SolderedElectronics/Soldered-Inkplate-6-FLICK-hardware-design/CAD/V1.2.0/Source 3D files/Inkplate 6 FLICK bottom  v1.1.0.step

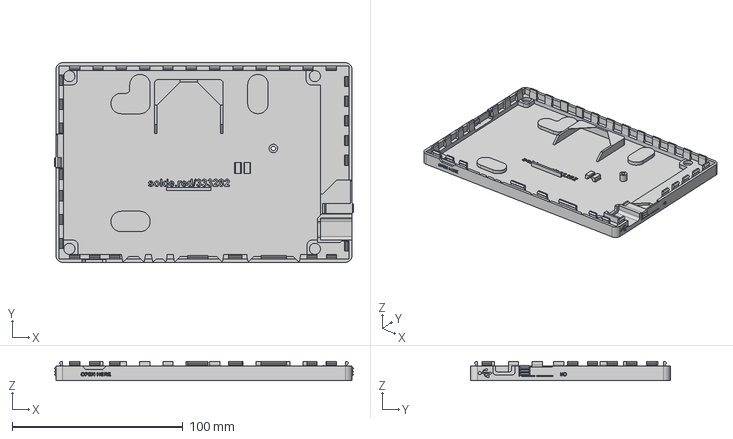
[picture p1: CAD file, 2024-10-20]
CAD/V1.2.0/Source 3D files/Inkplate 6 FLICK bottom v1.1.0.step
174.9 x 116.8 x 11.3 mm
