SolderedElectronics/Soldered-Inkplate-6-FLICK-hardware-design/OUTPUTS/V1.2.0/3D files/Inkplate 6 FLICK Top v1.1.1..stl

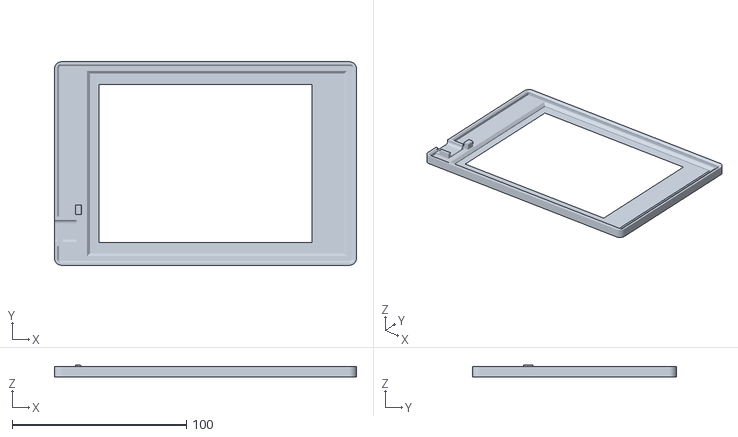
[picture p2: CAD file, 2024-10-20]
OUTPUTS/V1.2.0/3D files/Inkplate 6 FLICK Top v1.1.1..stl
173.3 x 116.8 x 6.60
