SolderedElectronics/Soldered-Inkplate-6-FLICK-hardware-design/CAD/V1.0.0/Source 3D files/Soldered Inkplate 6plus v1.2.0. Bottom v1.2.3..step

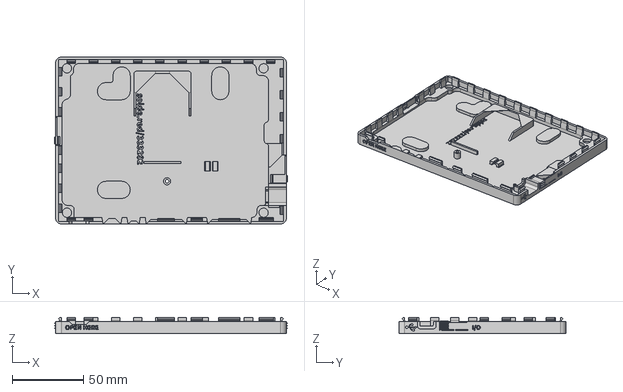
[picture p3: CAD file, 2025-01-28, an earlier design]
CAD/V1.0.0/Source 3D files/Soldered Inkplate 6plus v1.2.0. Bottom v1.2.3..step
163.0 x 116.8 x 11.3 mm
