SolderedElectronics/Soldered-Inkplate-6-FLICK-hardware-design/CAD/V1.0.0/Source 3D files/Soldered Inkplate 6plus v1.2.0. Top v1.2.1..step

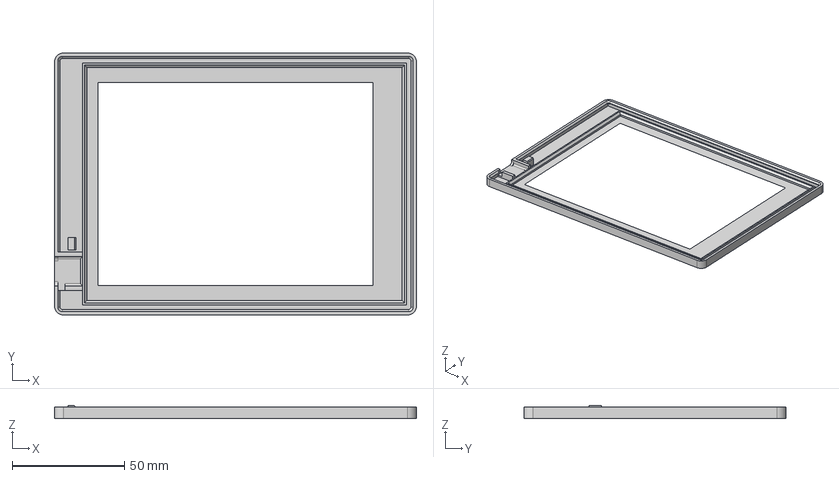
[picture p4: CAD file, 2025-01-28, an earlier design]
CAD/V1.0.0/Source 3D files/Soldered Inkplate 6plus v1.2.0. Top v1.2.1..step
161.4 x 116.8 x 5.60 mm
