SolderedElectronics/Soldered-Inkplate-6-FLICK-hardware-design/(list of files, cad)

Other CAD files:
CAD/V1.2.0/Source 3D files/Inkplate 6 FLICK Top v1.1.1.step
OUTPUTS/V1.2.0/3D files/Inkplate 6 FLICK bottom v1.1.0..stl
CAD/V1.0.0/Source 3D files/Soldered Inkplate 6plus v1.2.0. Bottom v1.2.3..f3d
CAD/V1.0.0/Source 3D files/Soldered Inkplate 6plus v1.2.0. Top v1.2.1..f3d
