SolderedElectronics/Soldered-Inkplate-6-FLICK-hardware-design/OUTPUTS/V1.2.0/Soldered Inkplate 6 FLICK Schematics.pdf

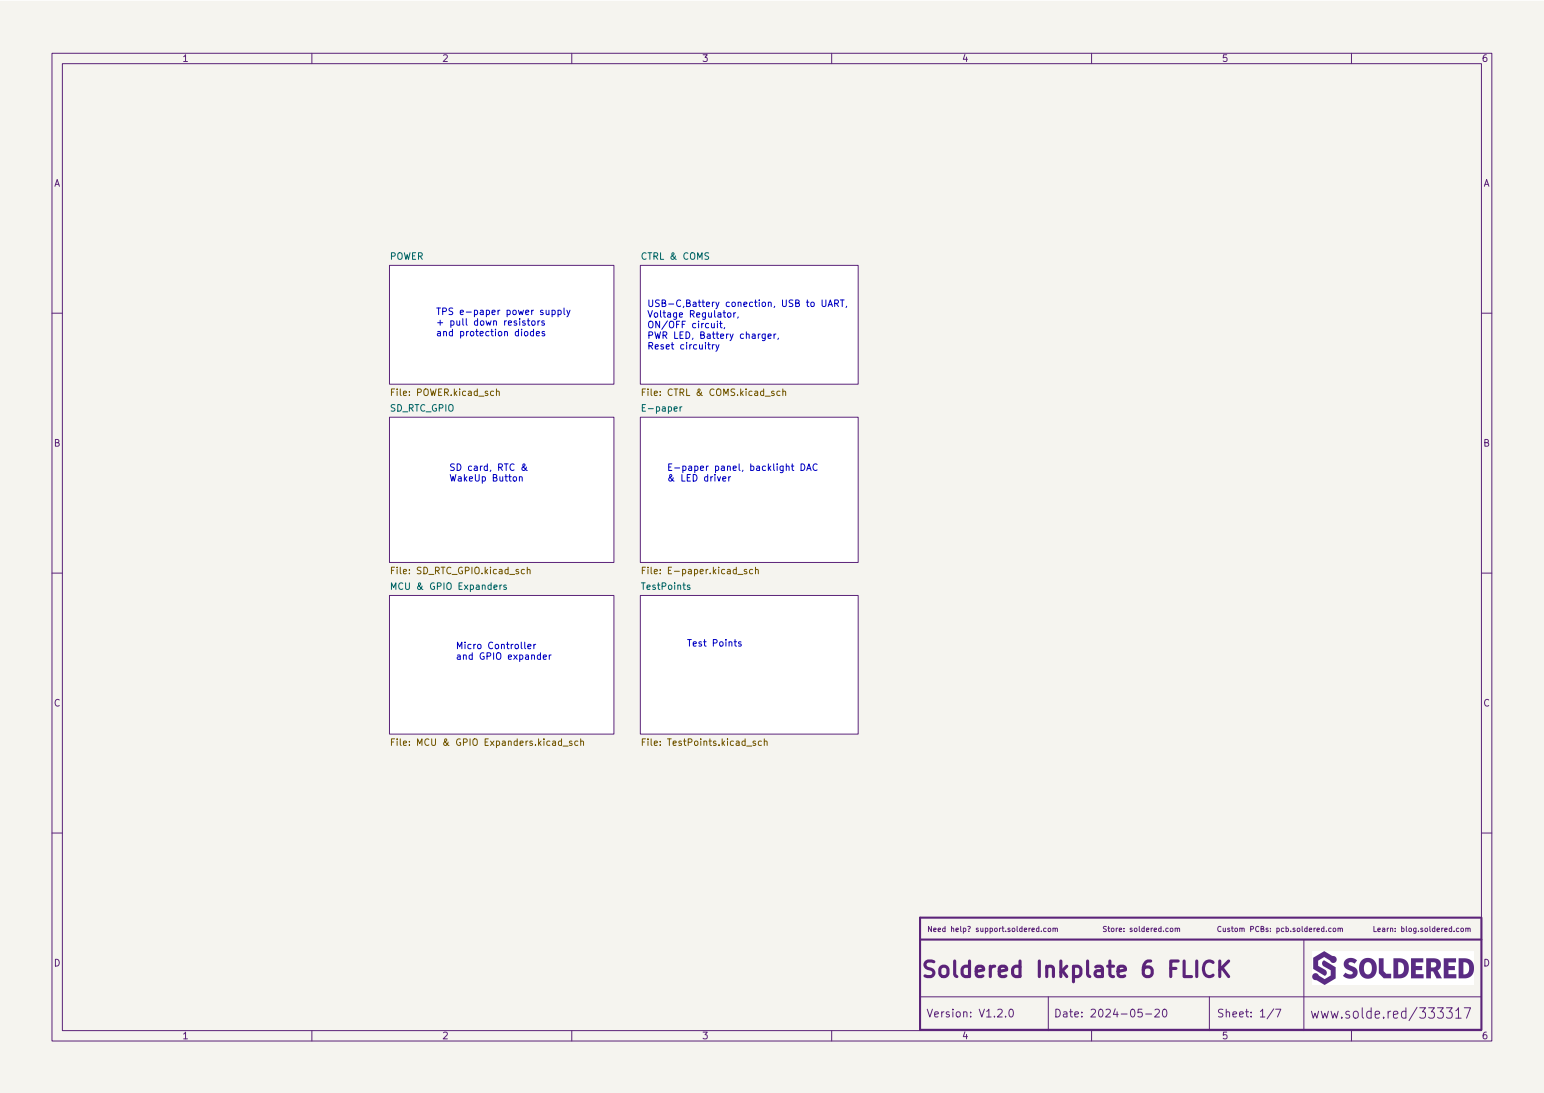
[picture p5: page 1]

POWER
and protection diodes Micro Controller and GPIO expander SD card, RTC & WakeUp Button
Reset circuitry Test Points E-paper panel, backlight DAC

USB-C,Battery conection, USB to UART,
Voltage Regulator, ON/OFF circuit, PWR LED, Battery charger,

TPS e-paper power supply
+ pull down resistors

File: CTRL & COMS.kicad_sch E-paper

File: SD_RTC_GPIO.kicad_sch MCU & GPIO Expanders

File: E-paper.kicad_sch TestPoints File: TestPoints.kicad_sch

File: MCU & GPIO Expanders.kicad_sch

Learn: blog.soldered.com

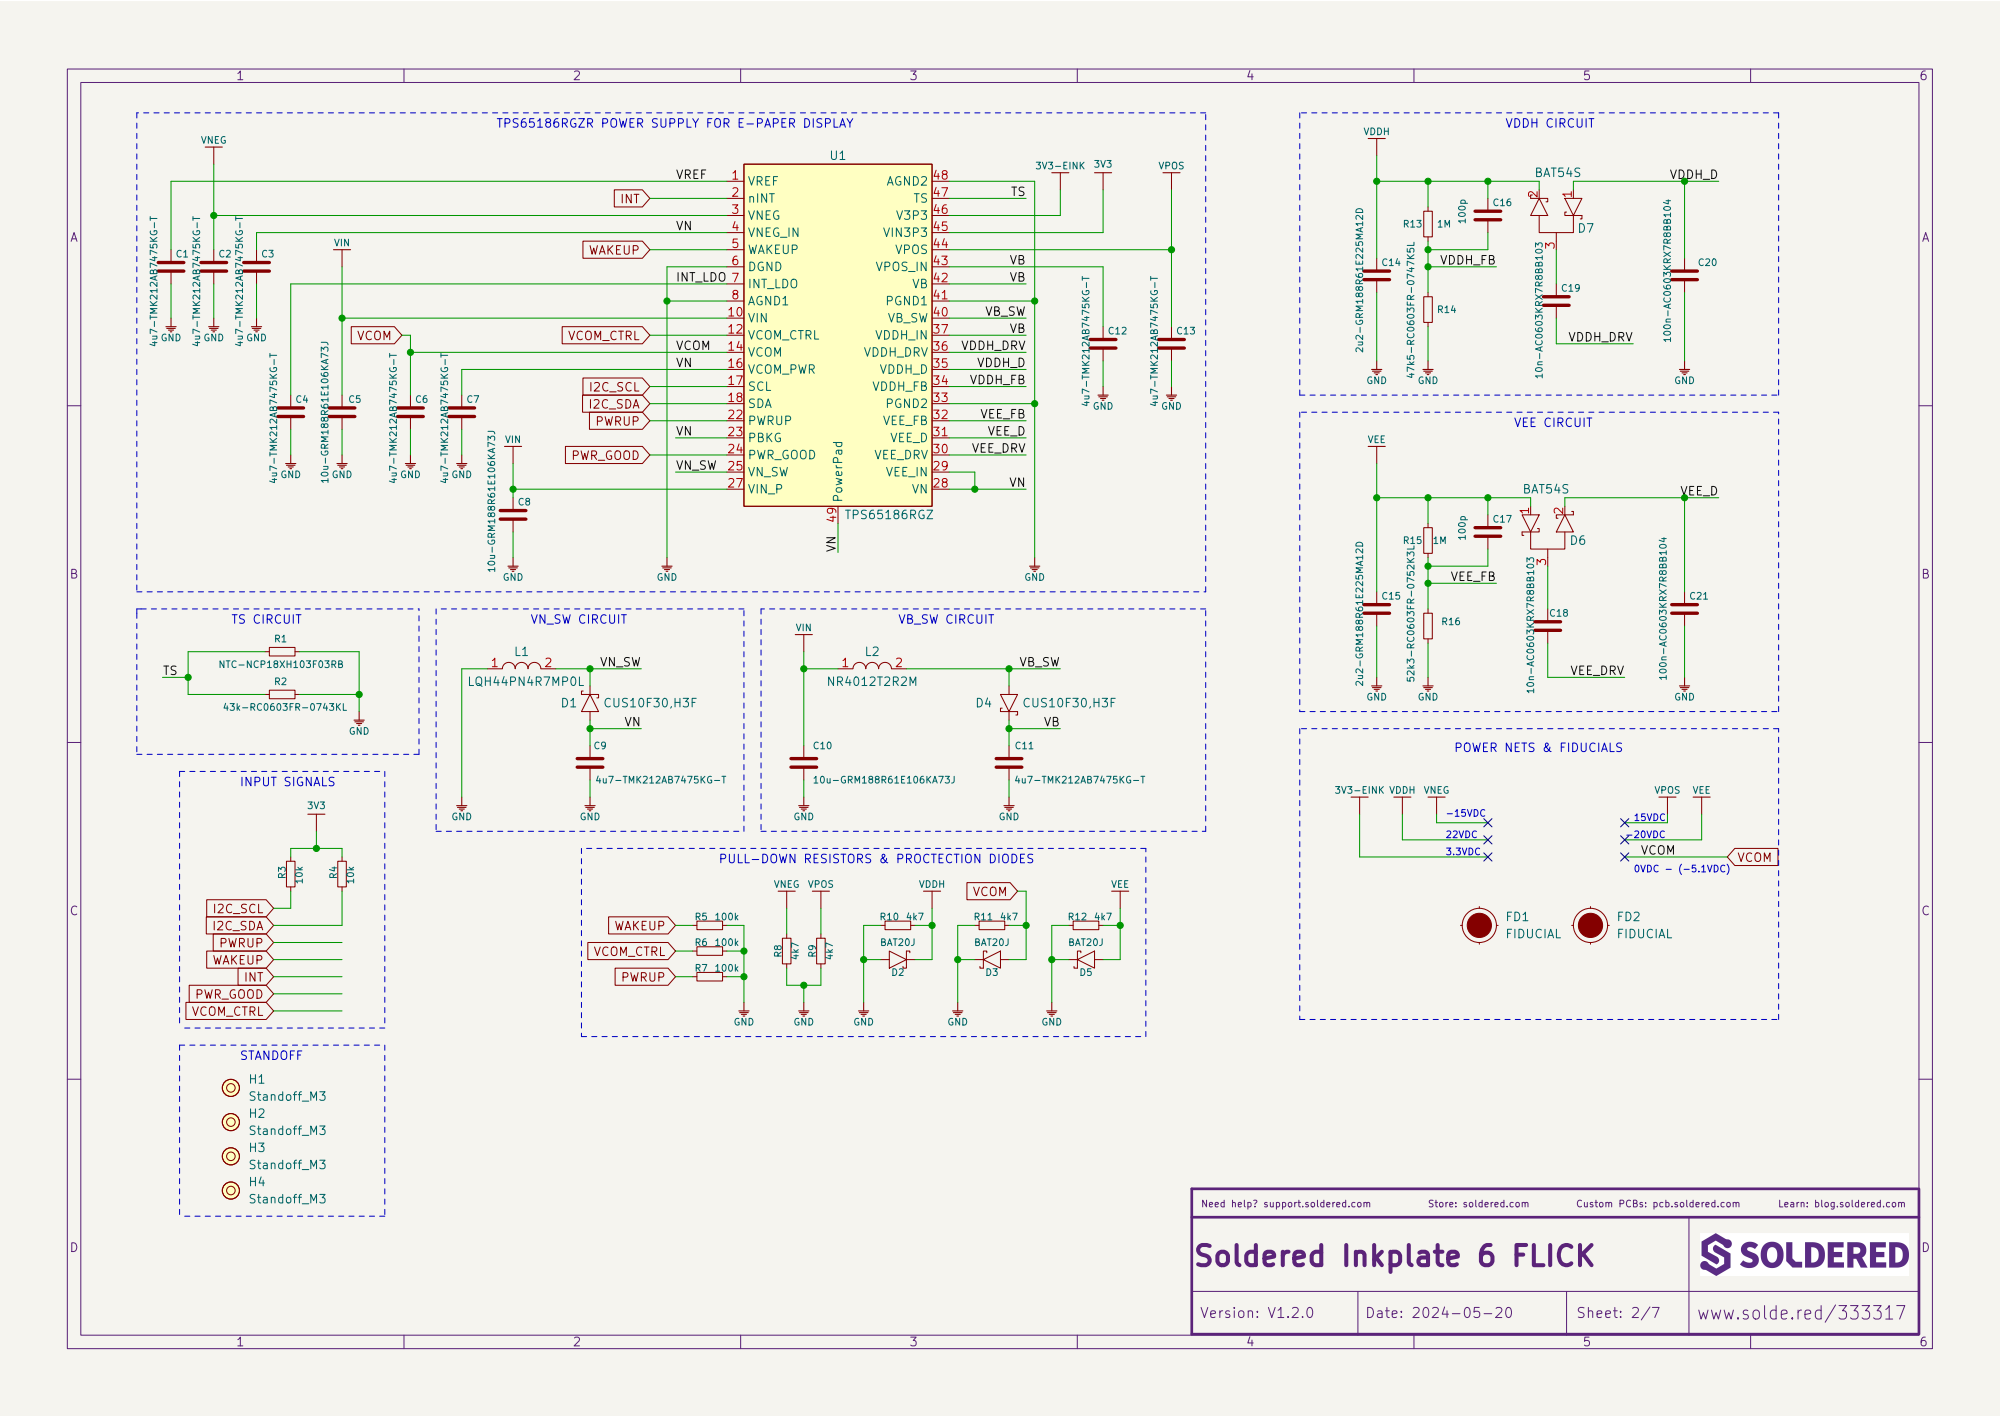
[picture p6: page 2]

INT_LDO | VB

Learn: blog.soldered.com

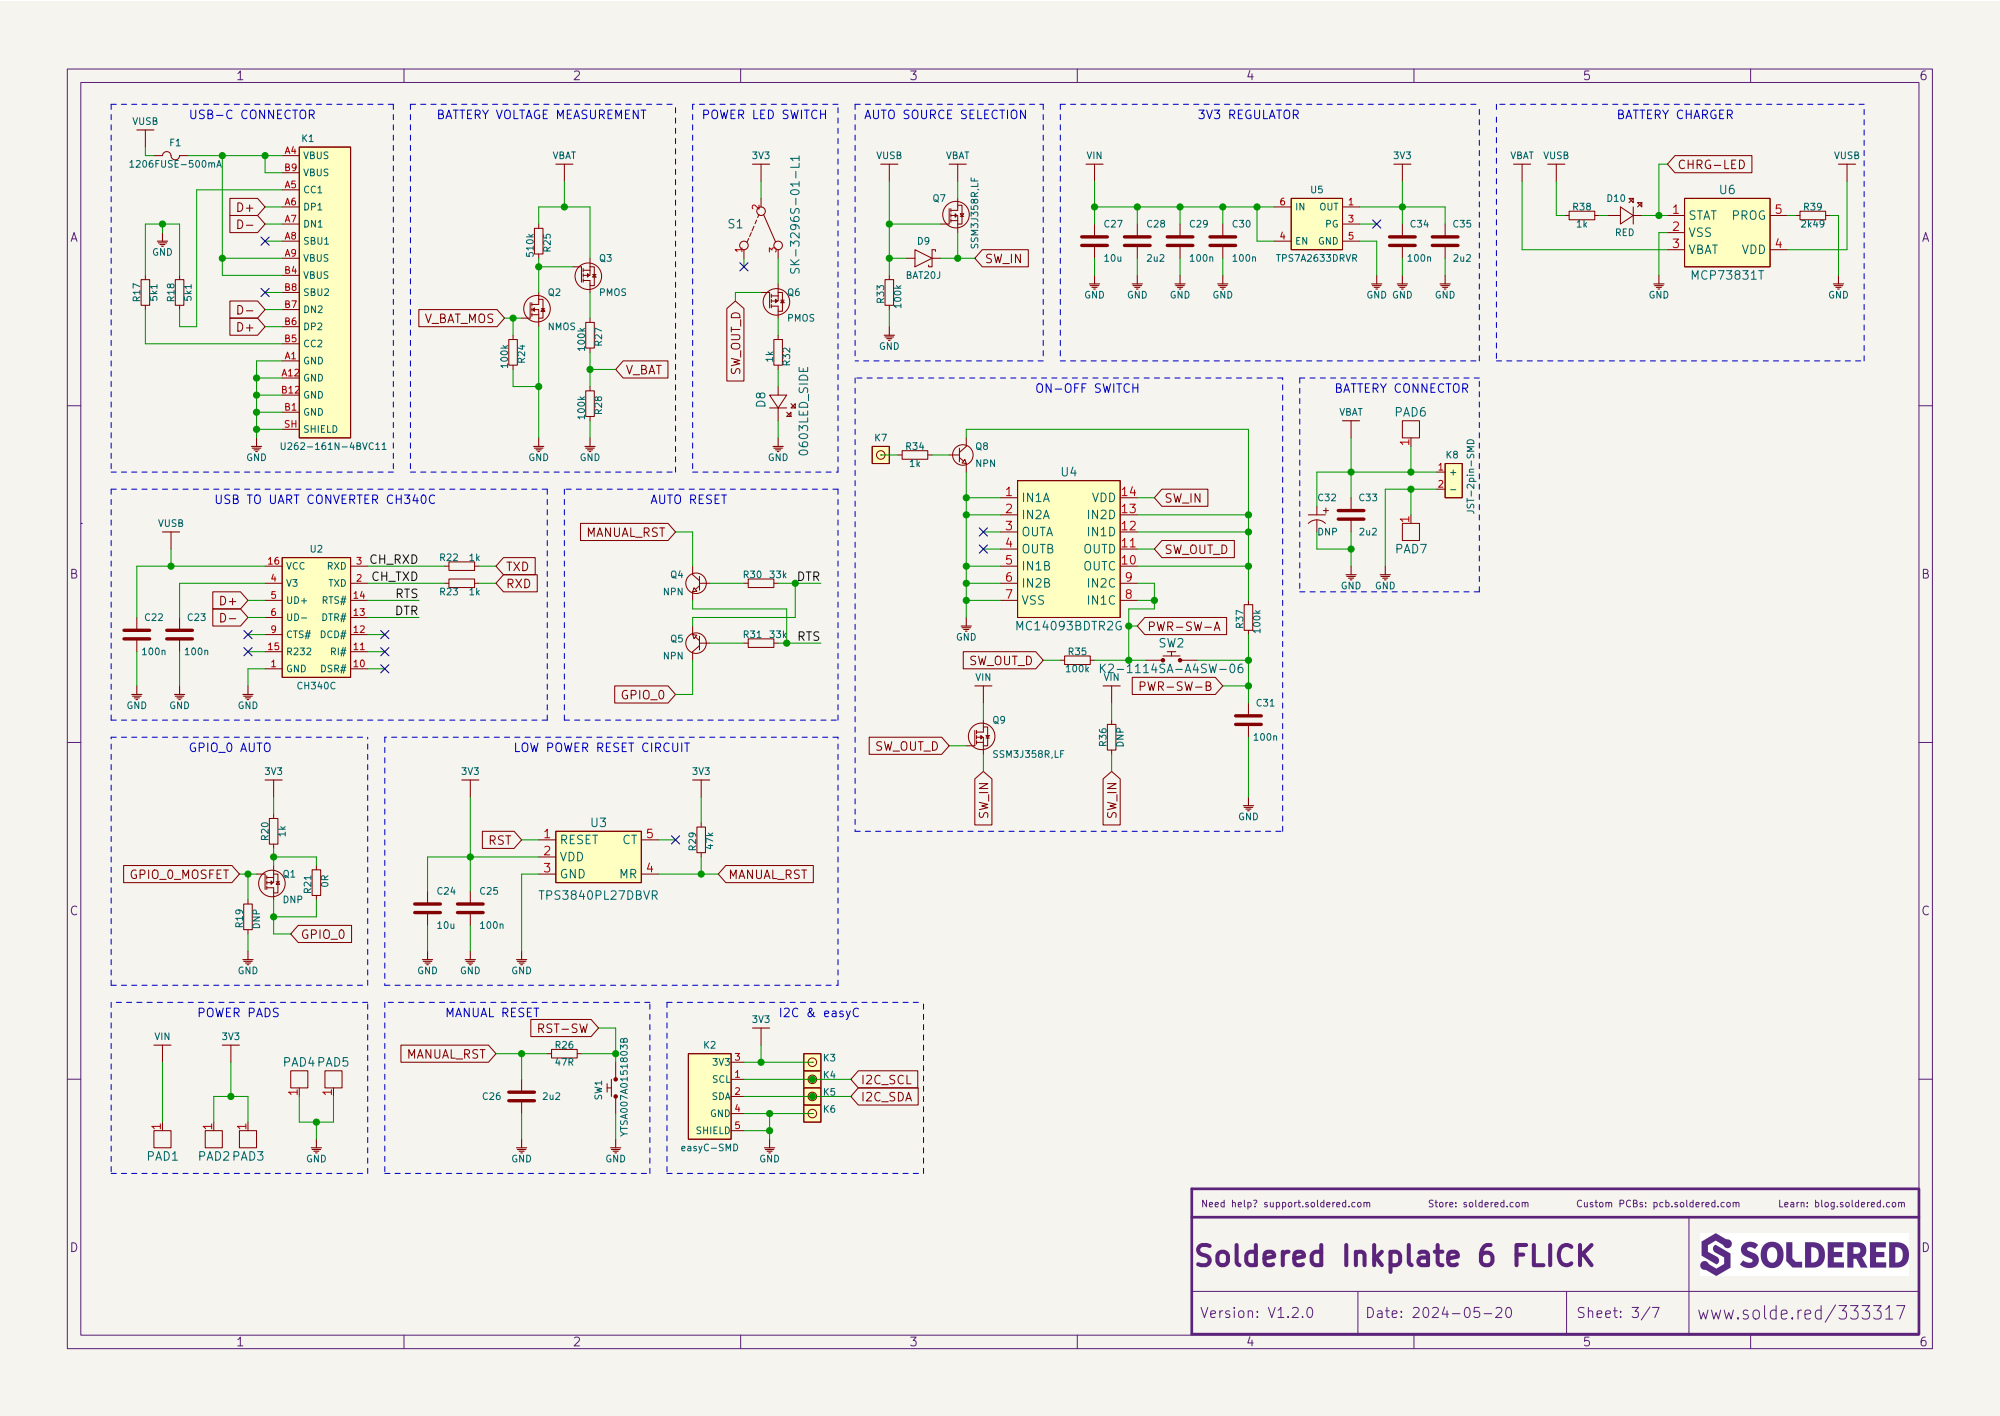
[picture p7: page 3]

USB TO UART CONVERTER CH340C

1 PAD3 R29 47k GND 1 DSR# 10 RI# 11 DCD# 12 DTR# 13 RTS# 14 R232 15 VCC 16 TXD 2 RXD 3 V3 4 UD+ 5 UD- 6 CTS# 9 U2 CH340C

LOW POWER RESET CIRCUIT

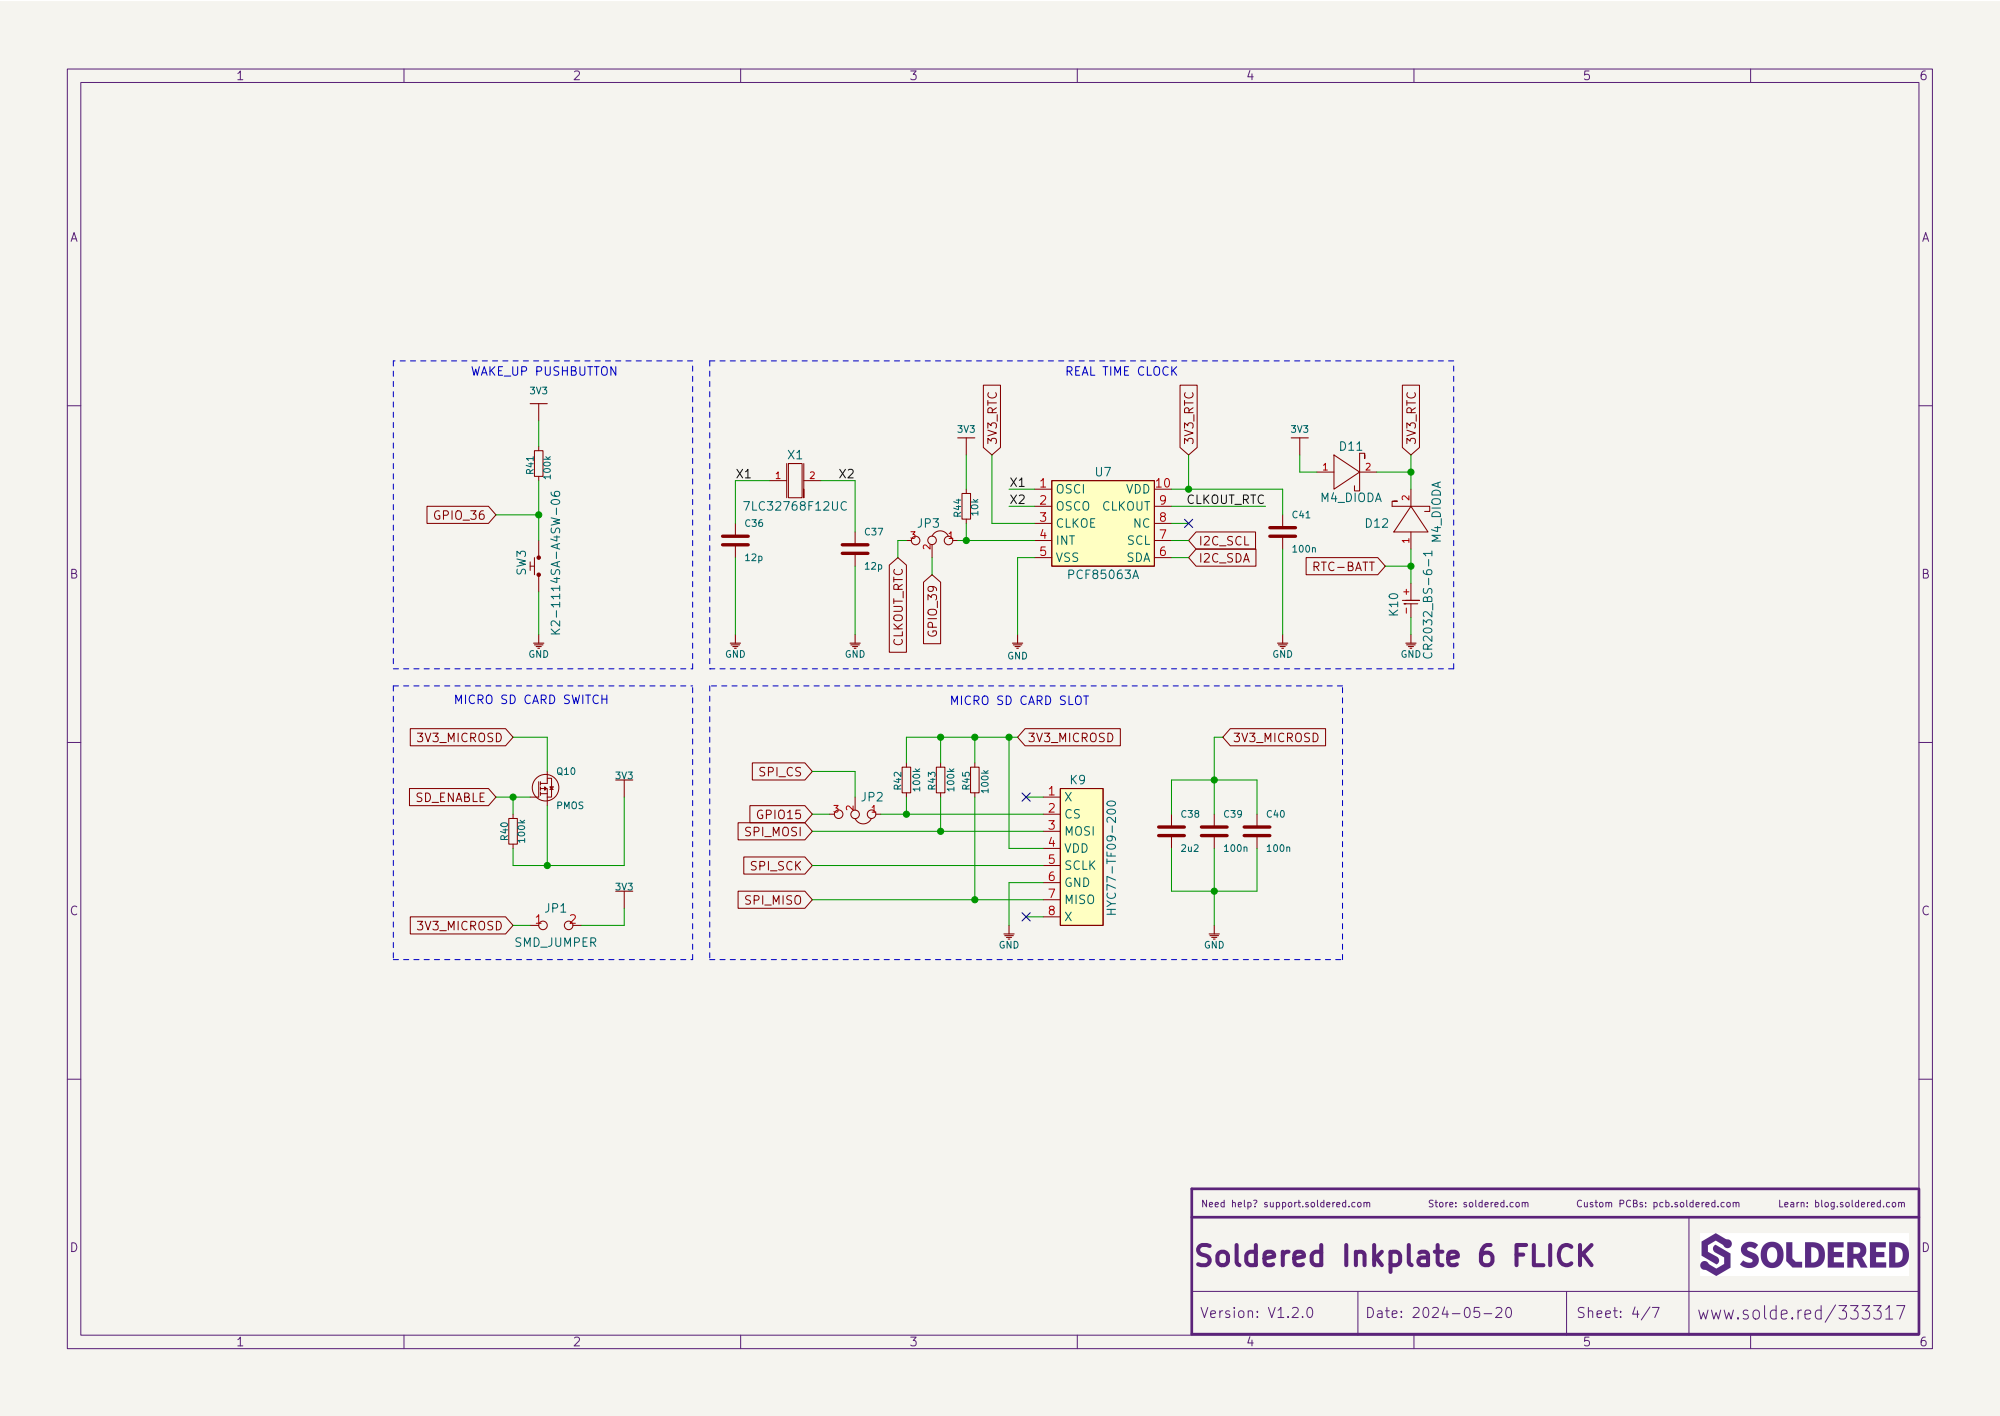
[picture p8: page 4]

REAL TIME CLOCK MICRO SD CARD SLOT WAKE_UP PUSHBUTTON

Learn: blog.soldered.com

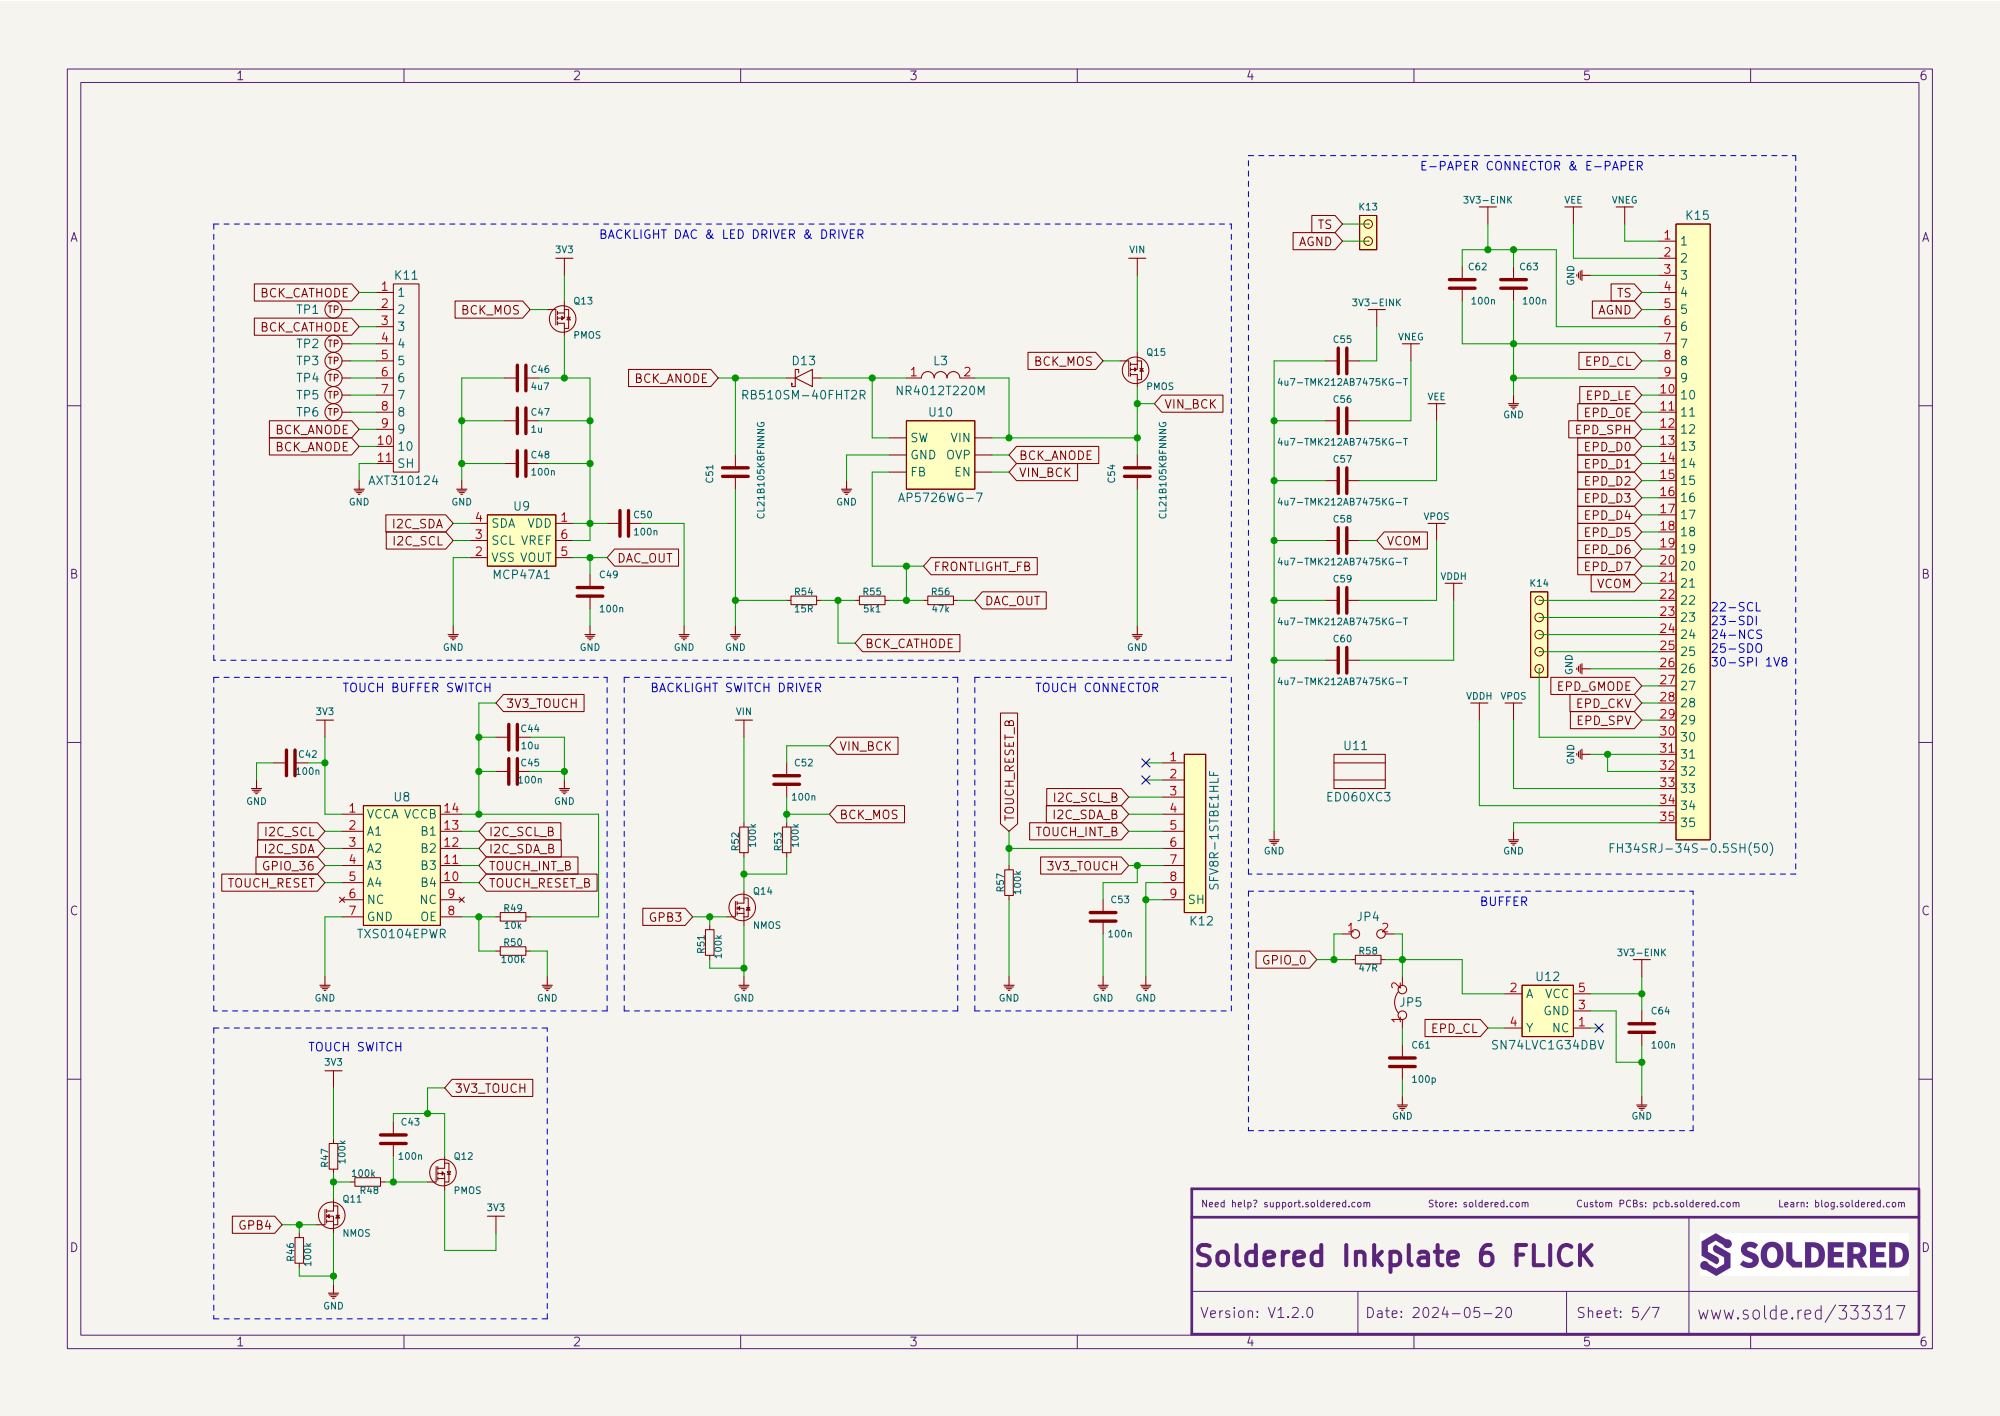
[picture p9: page 5]

BACKLIGHT DAC & LED DRIVER & DRIVER
VIN Q13 PMOS

100n GND TP4 TP TP6 TP TP5 TP

Learn: blog.soldered.com

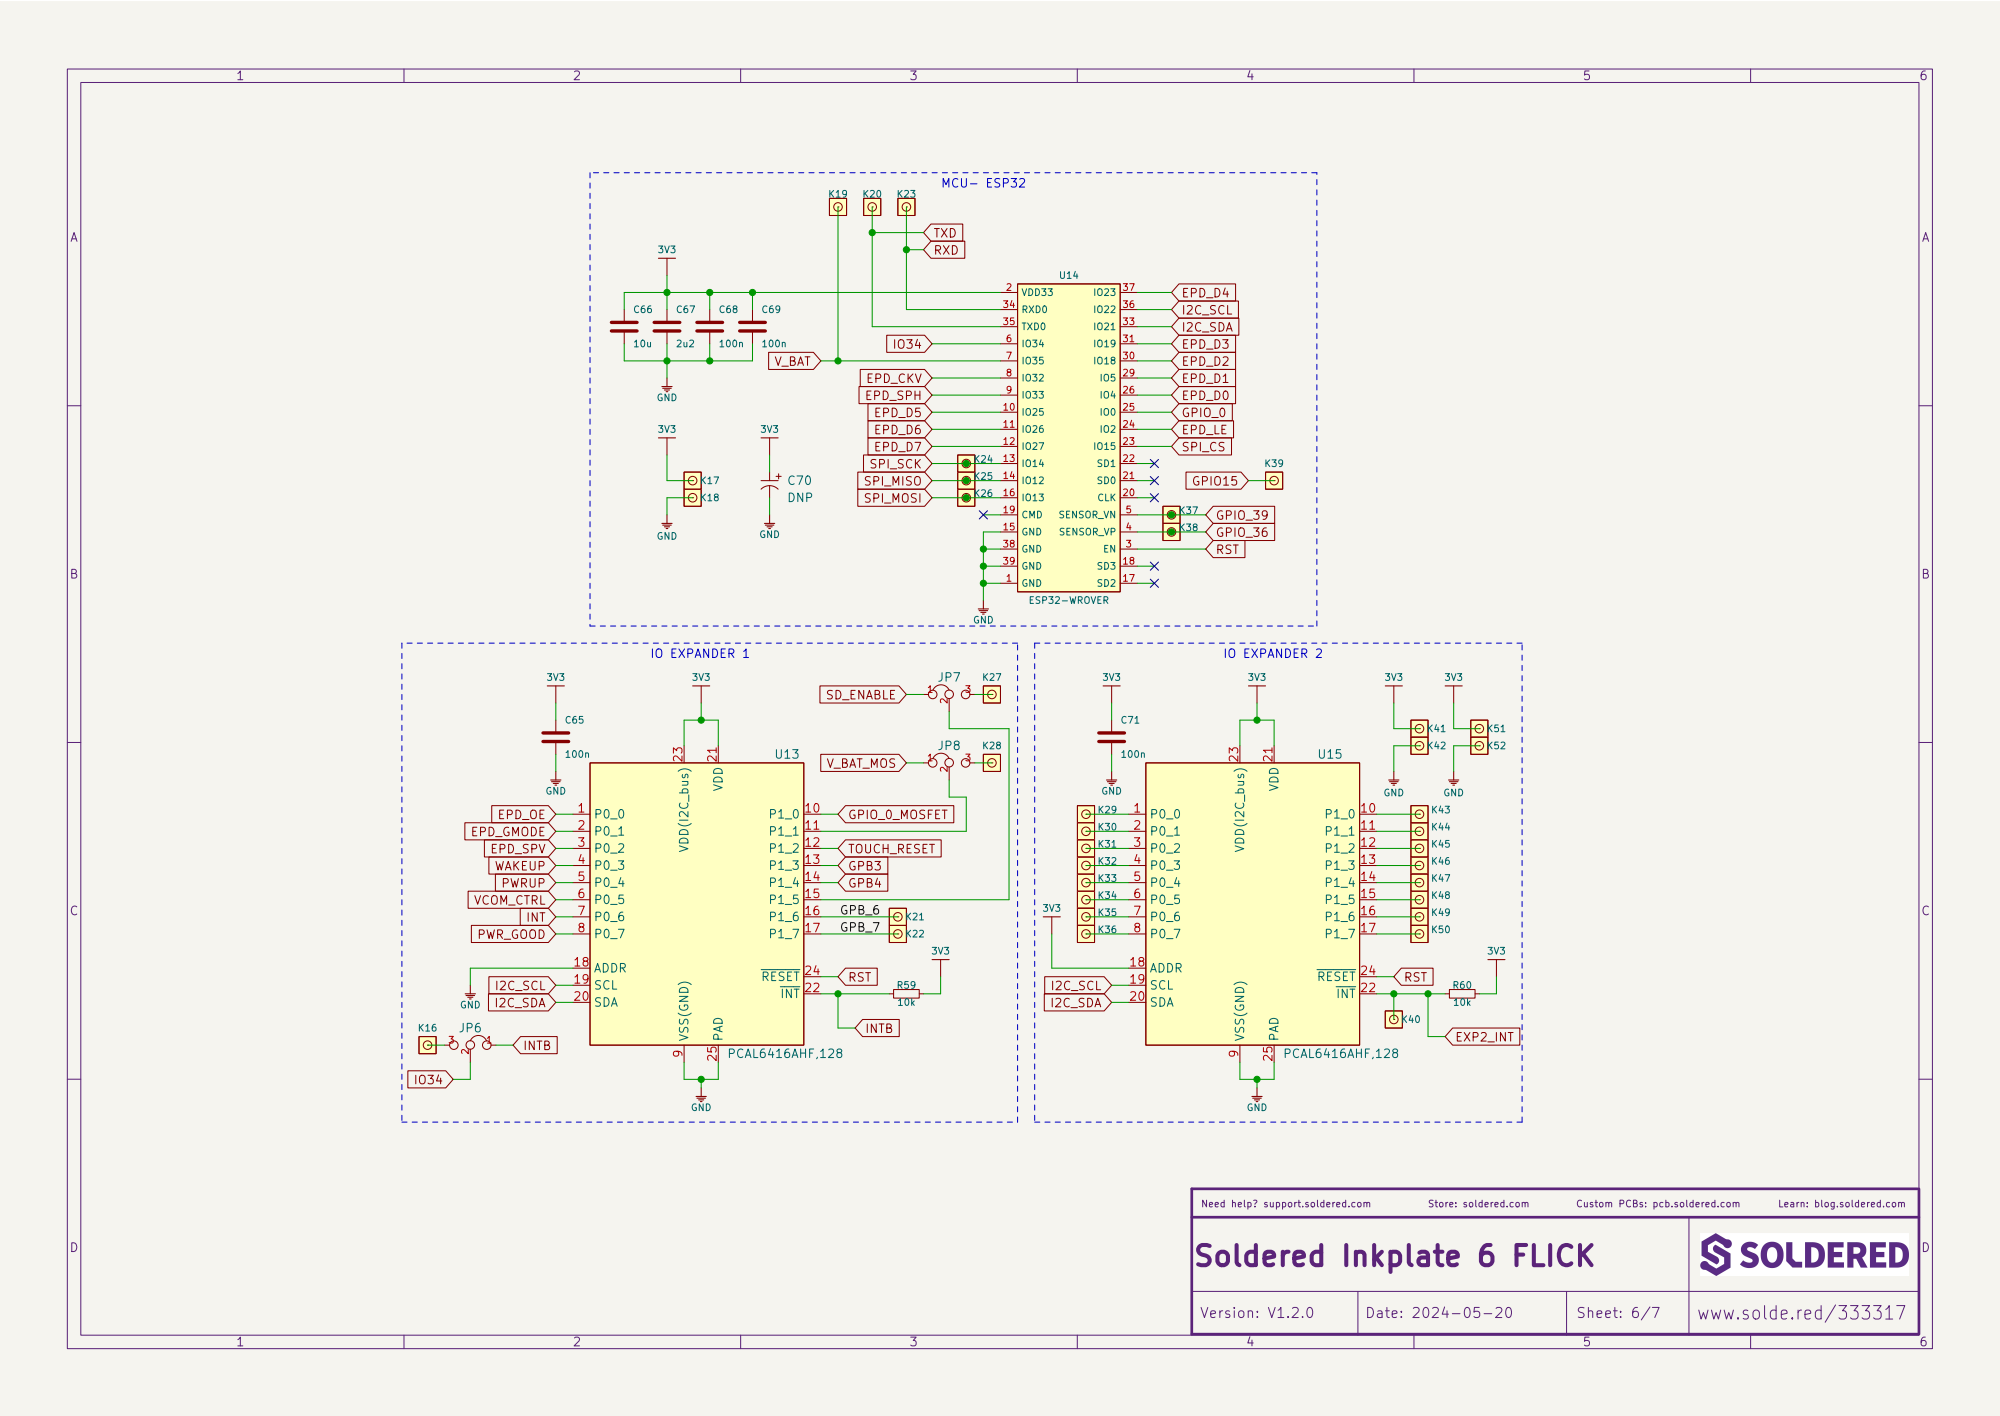
[picture p10: page 6]

Learn: blog.soldered.com

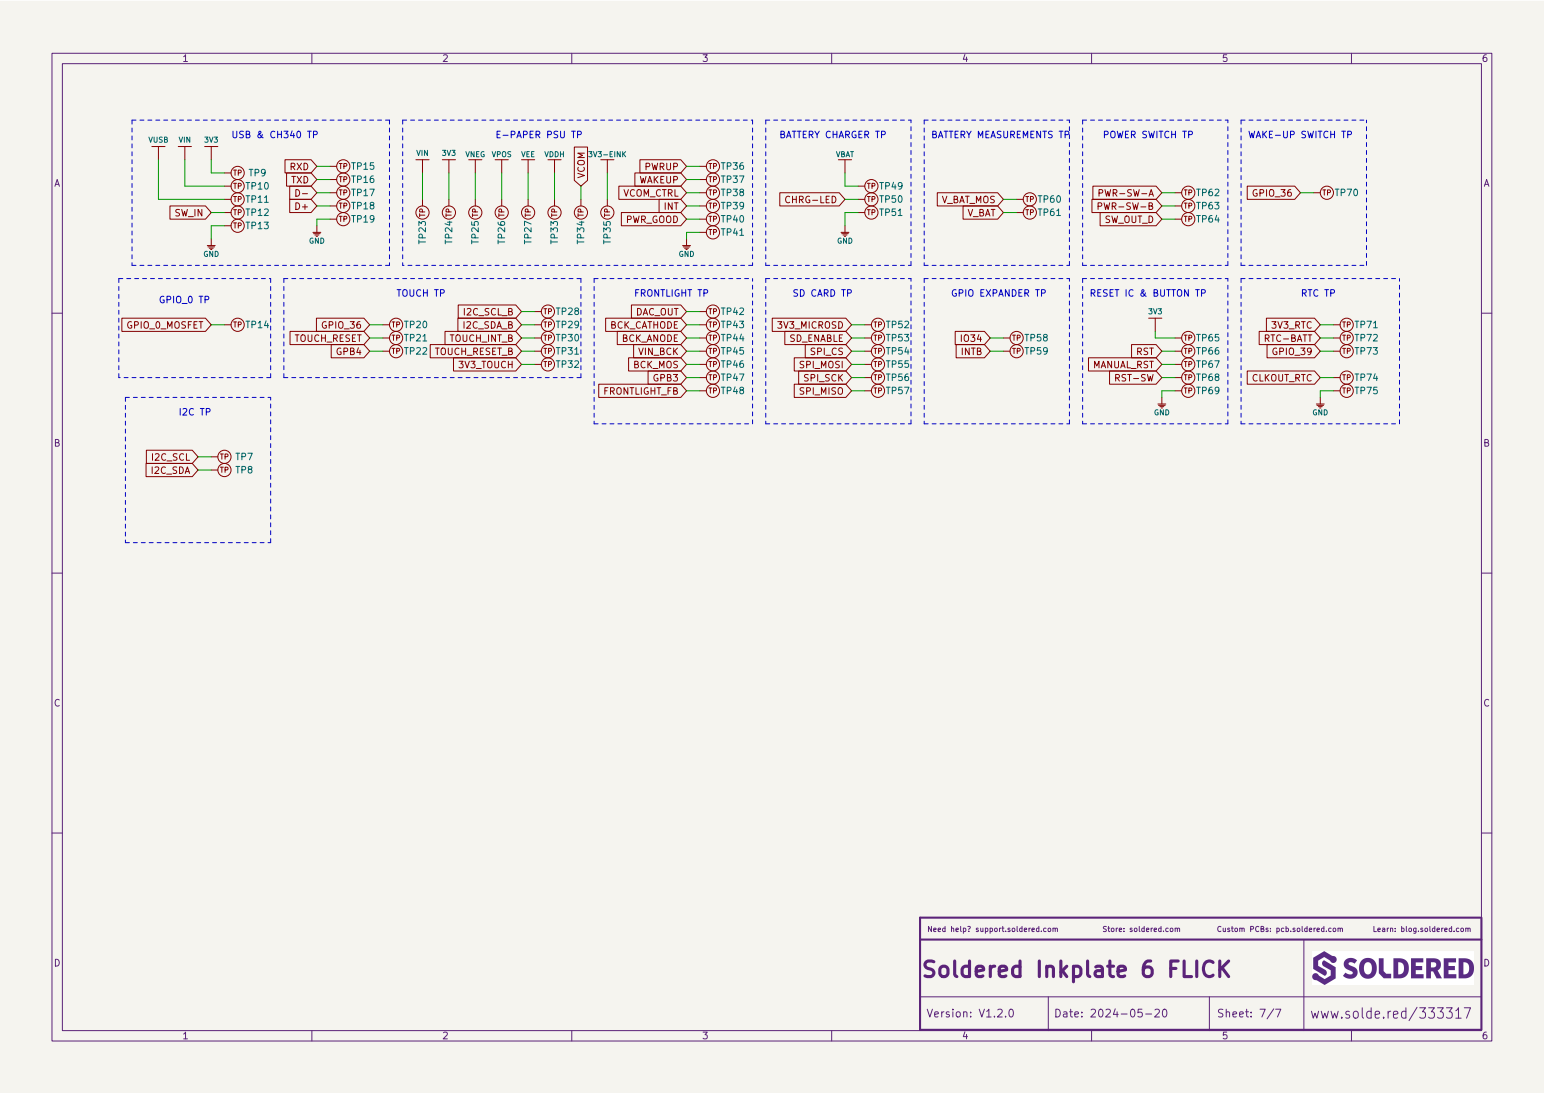
[picture p11: page 7]

Learn: blog.soldered.com
