SolderedElectronics/Soldered-Inkplate-6-FLICK-hardware-design/OUTPUTS/V1.0.0/Soldered Inkplate 6FLICK Schematics.pdf

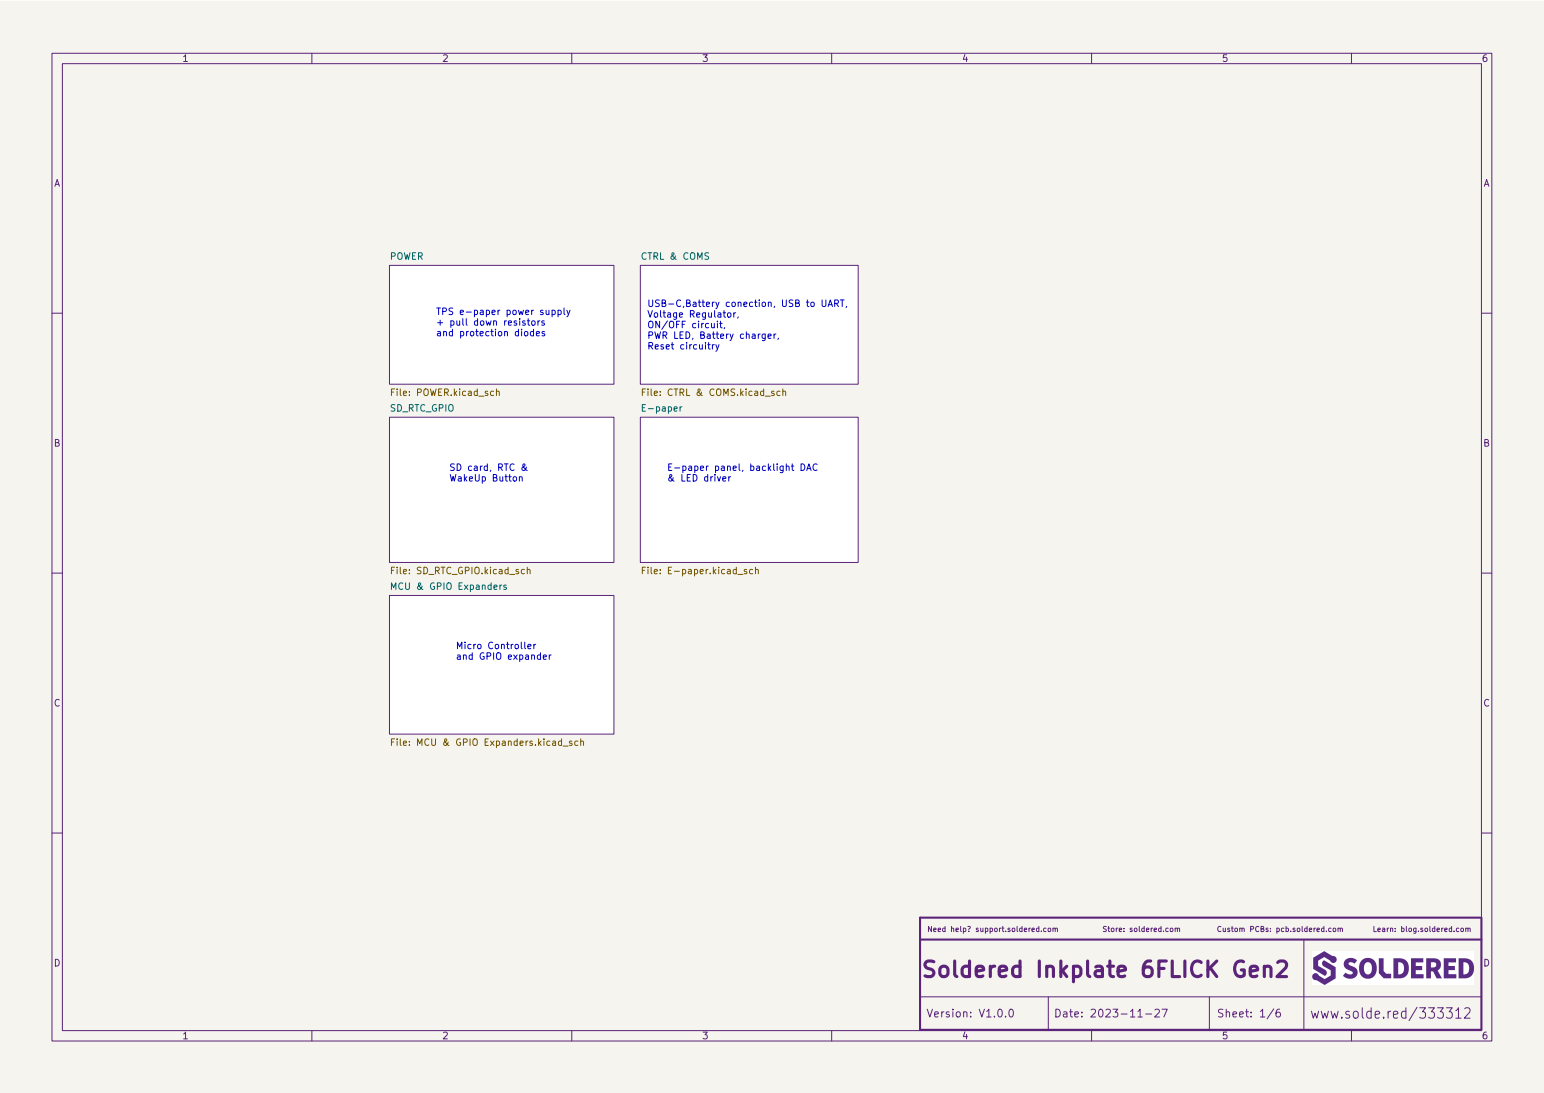
[picture p12: page 1]

File: CTRL & COMS.kicad_sch POWER

CTRL & COMS
and protection diodes Micro Controller and GPIO expander SD card, RTC & WakeUp Button

USB-C,Battery conection, USB to UART,
Voltage Regulator, ON/OFF circuit, PWR LED, Battery charger,

TPS e-paper power supply
+ pull down resistors

E-paper panel, backlight DAC
& LED driver

File: SD_RTC_GPIO.kicad_sch MCU & GPIO Expanders

File: MCU & GPIO Expanders.kicad_sch

Learn: blog.soldered.com

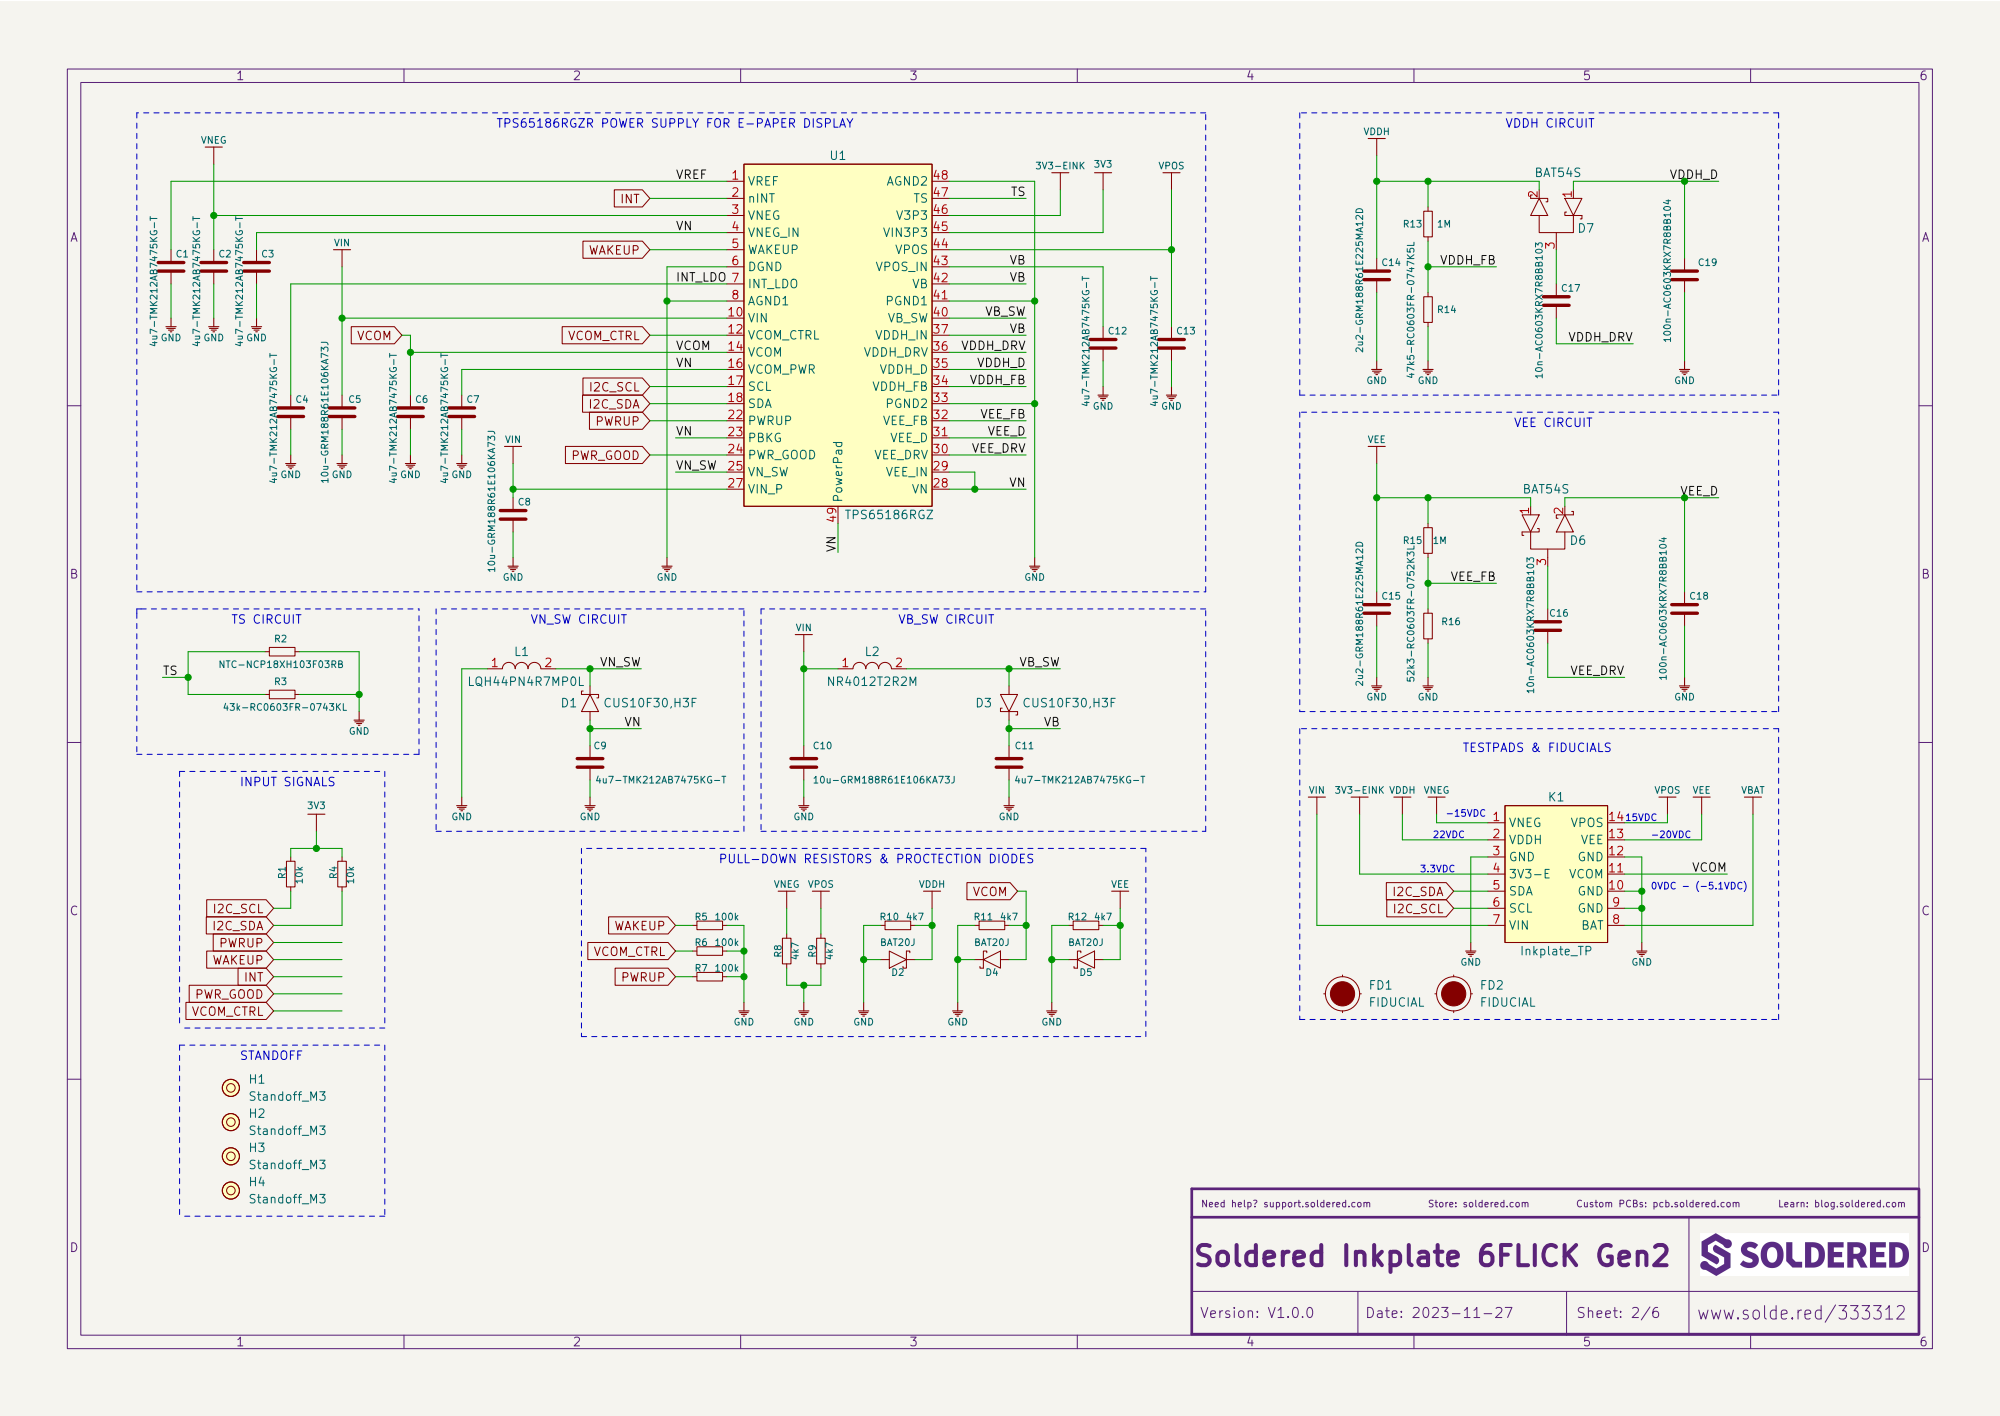
[picture p13: page 2]

0VDC - (-5.1VDC) 15VDC -15VDC PULL-DOWN RESISTORS & PROCTECTION DIODES

Learn: blog.soldered.com

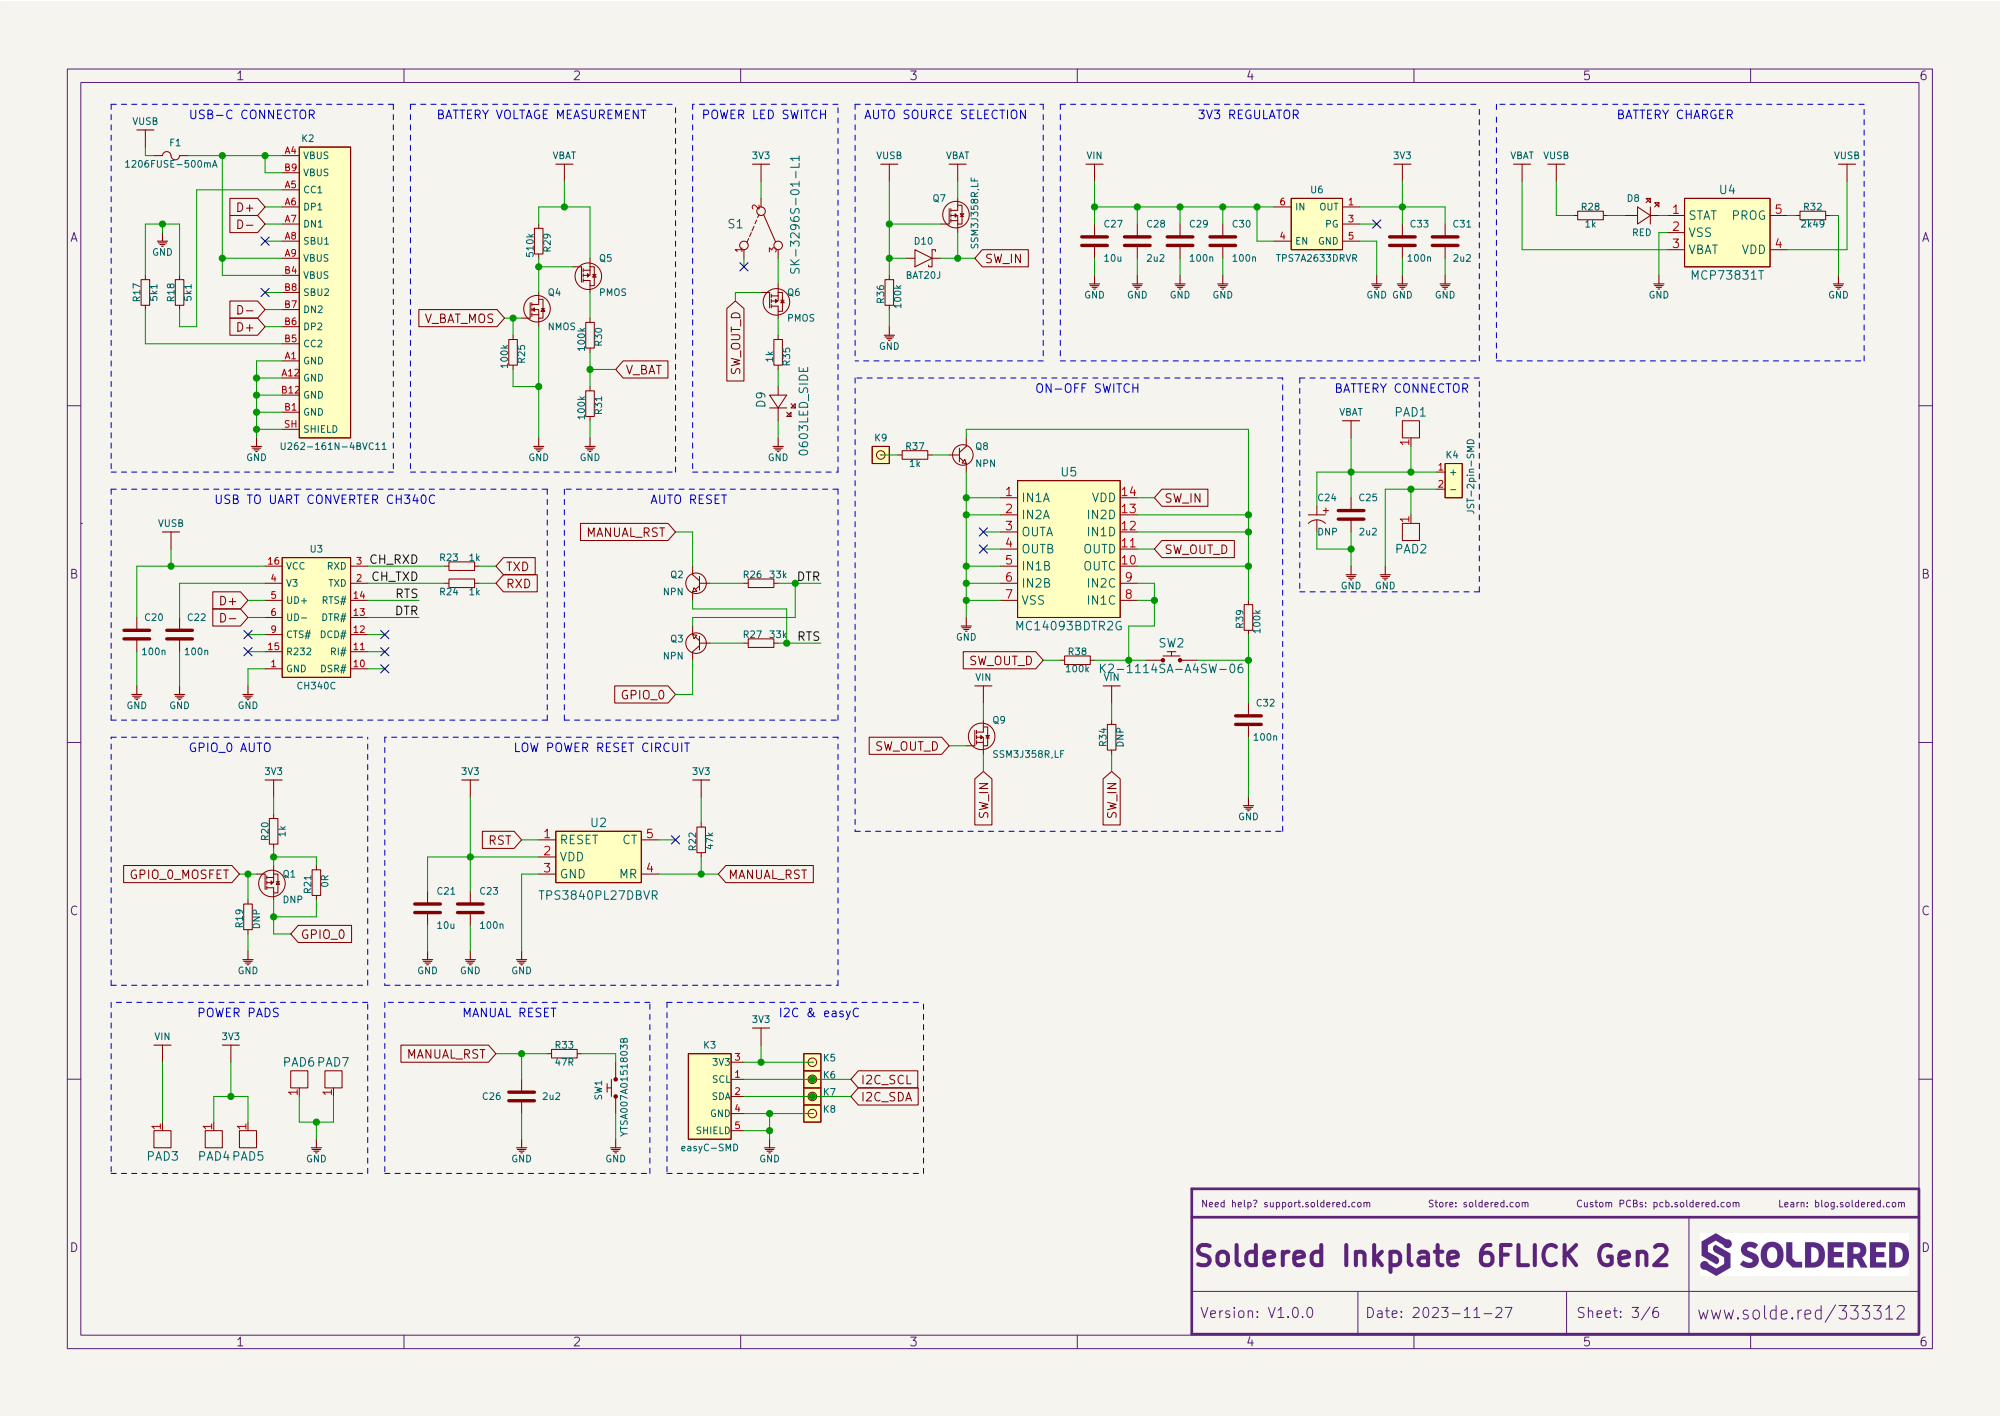
[picture p14: page 3]

- 2 K4 JST-2pin-SMD GND GND

USB TO UART CONVERTER CH340C

Learn: blog.soldered.com

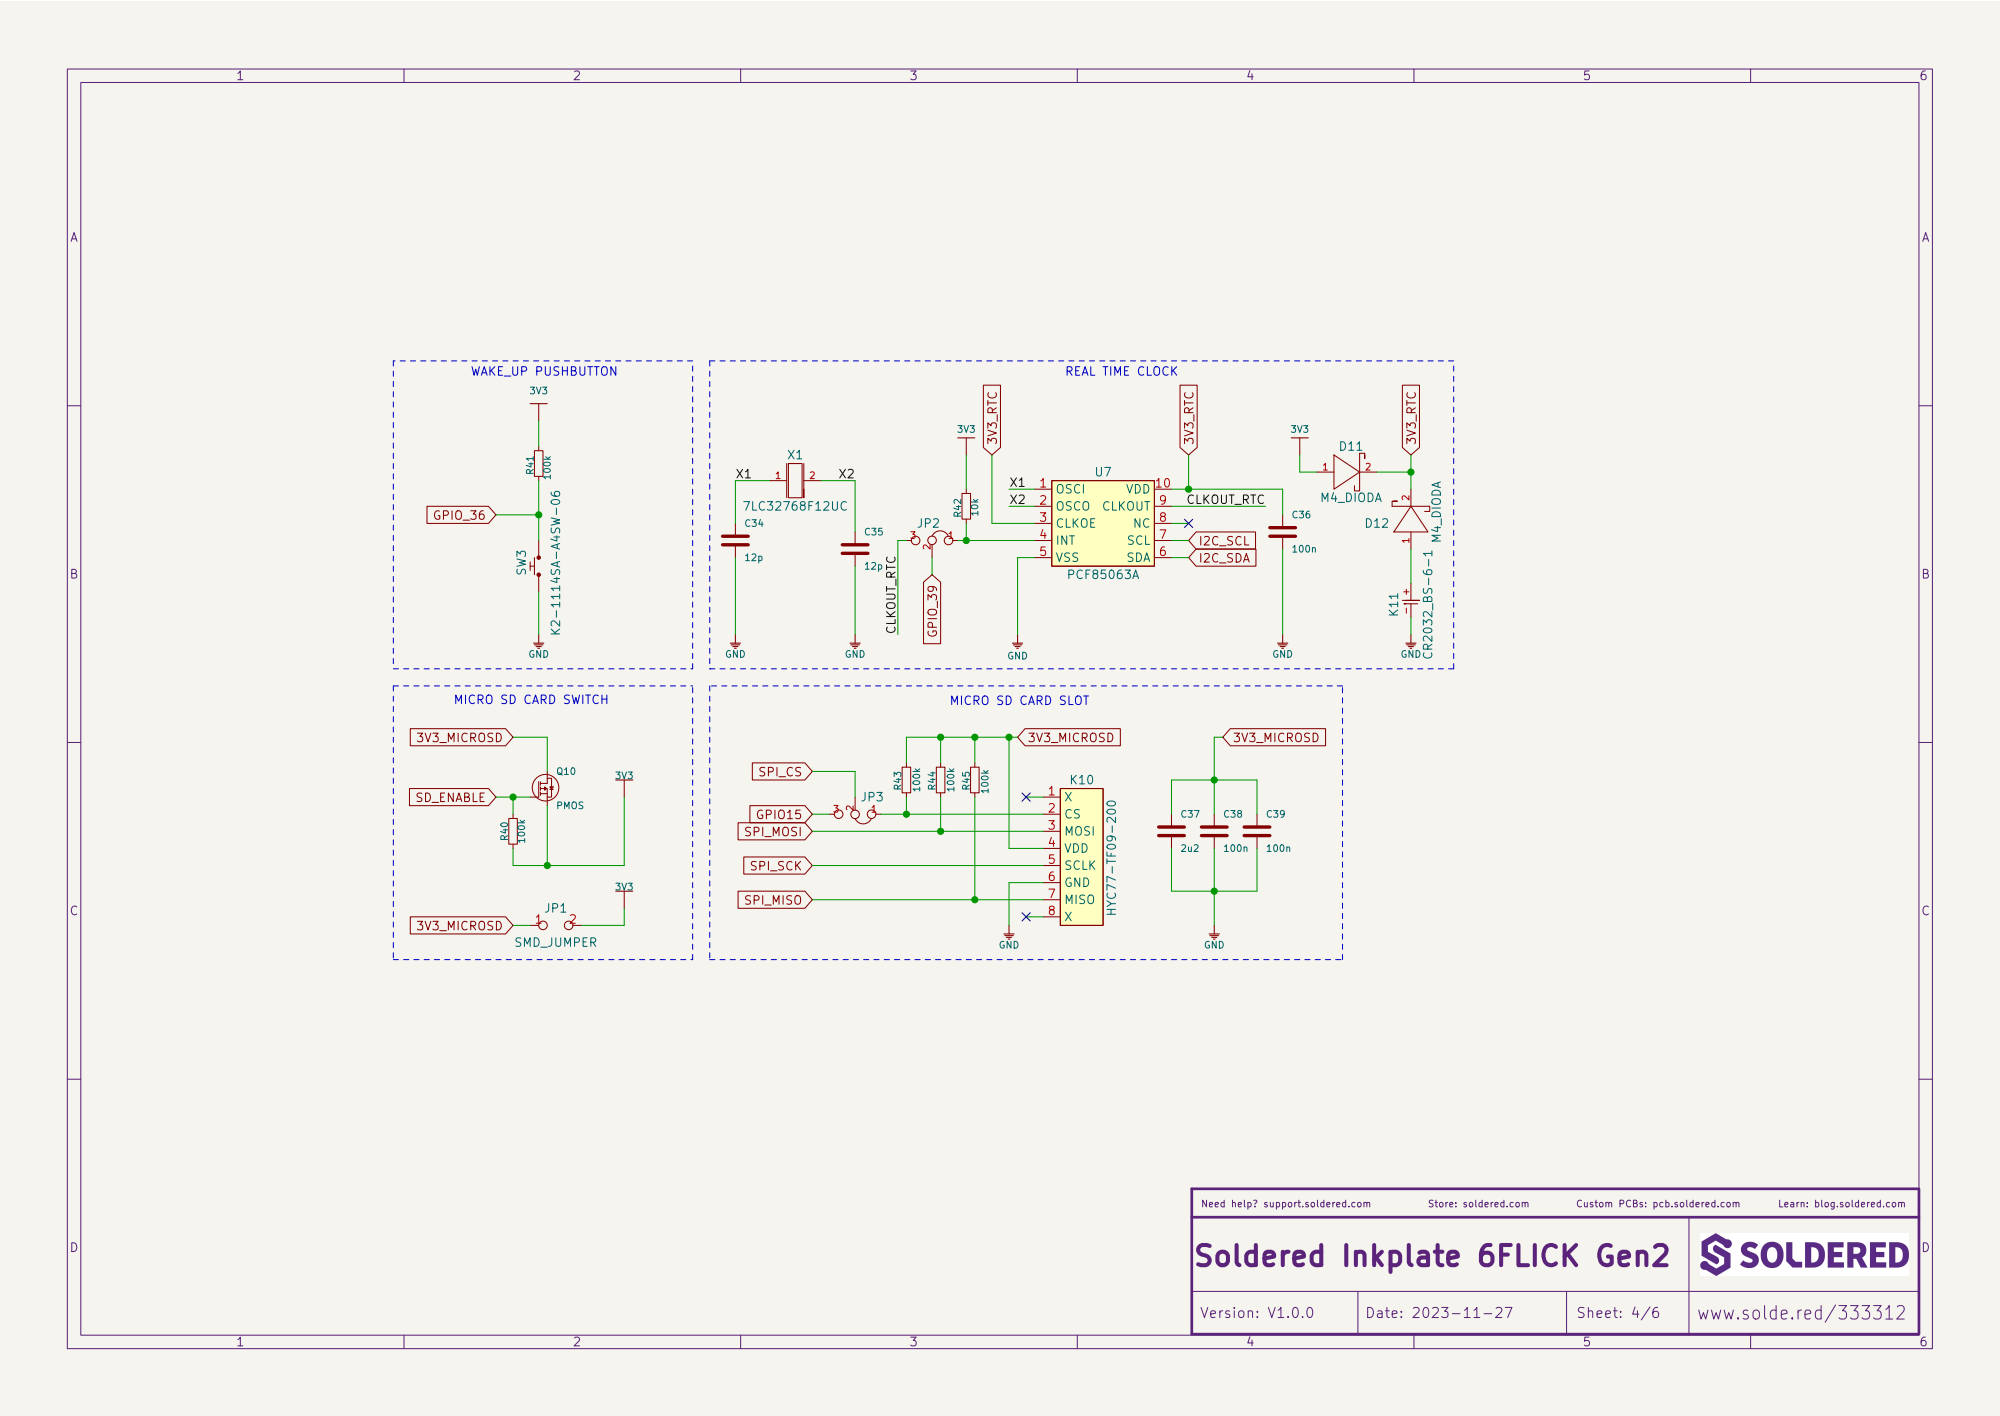
[picture p15: page 4]

Learn: blog.soldered.com

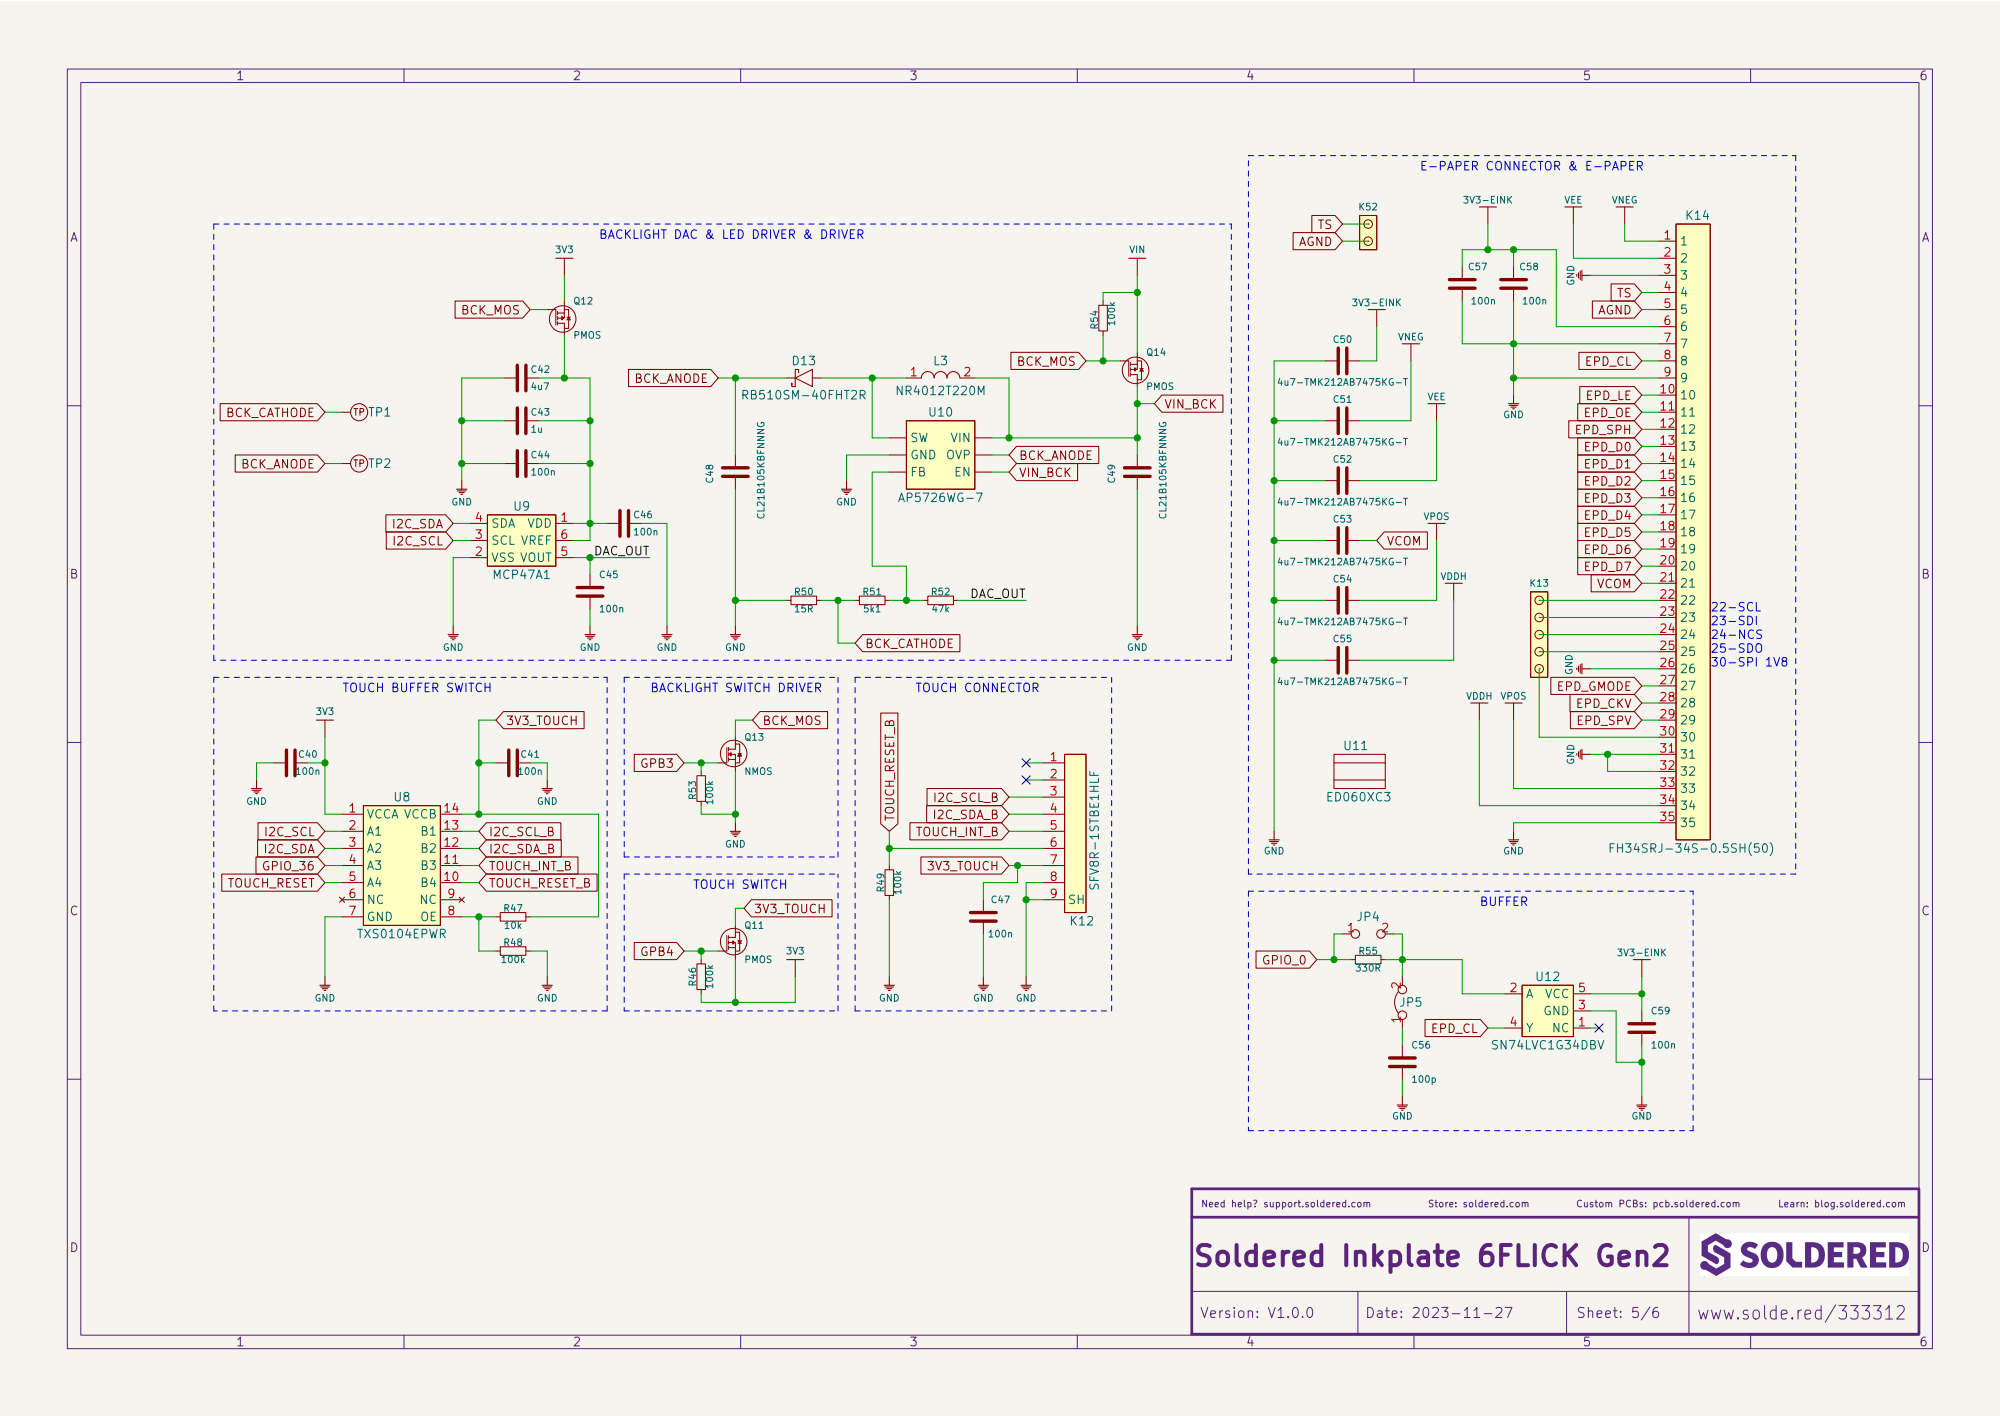
[picture p16: page 5]

BACKLIGHT DAC & LED DRIVER & DRIVER

30-SPI 1V8 BACKLIGHT SWITCH DRIVER

Learn: blog.soldered.com

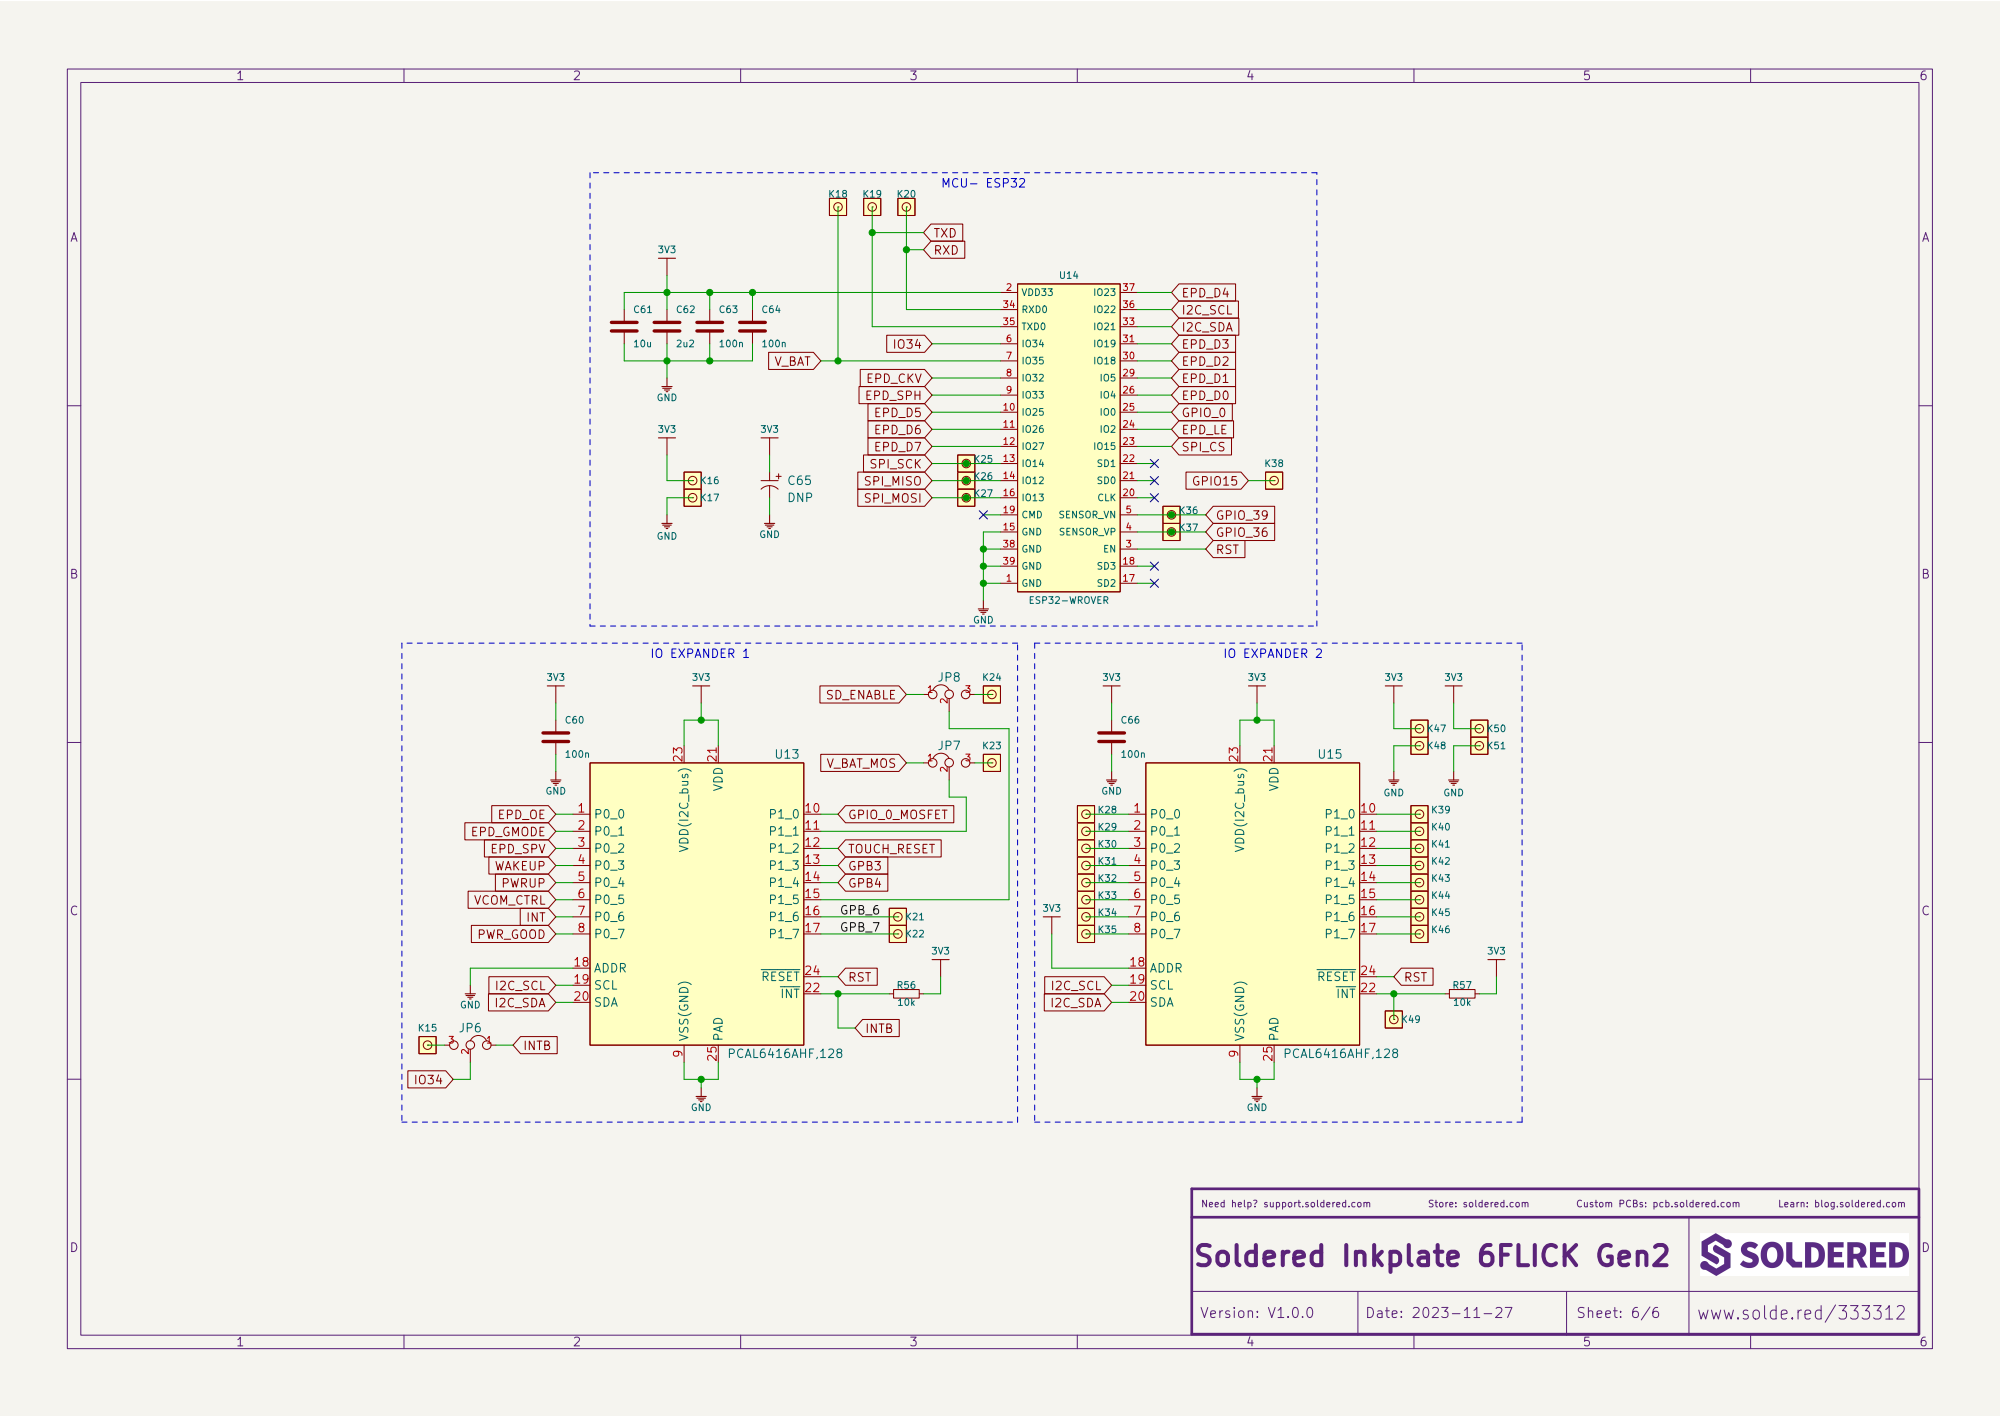
[picture p17: page 6]

Learn: blog.soldered.com
