SolderedElectronics/Soldered-Inkplate-6-FLICK-hardware-design/CAD/V1.2.0/CTRL & COMS.kicad_sch

## KiCad design CAD/V1.2.0/CTRL & COMS.kicad_sch (2024-10-20)

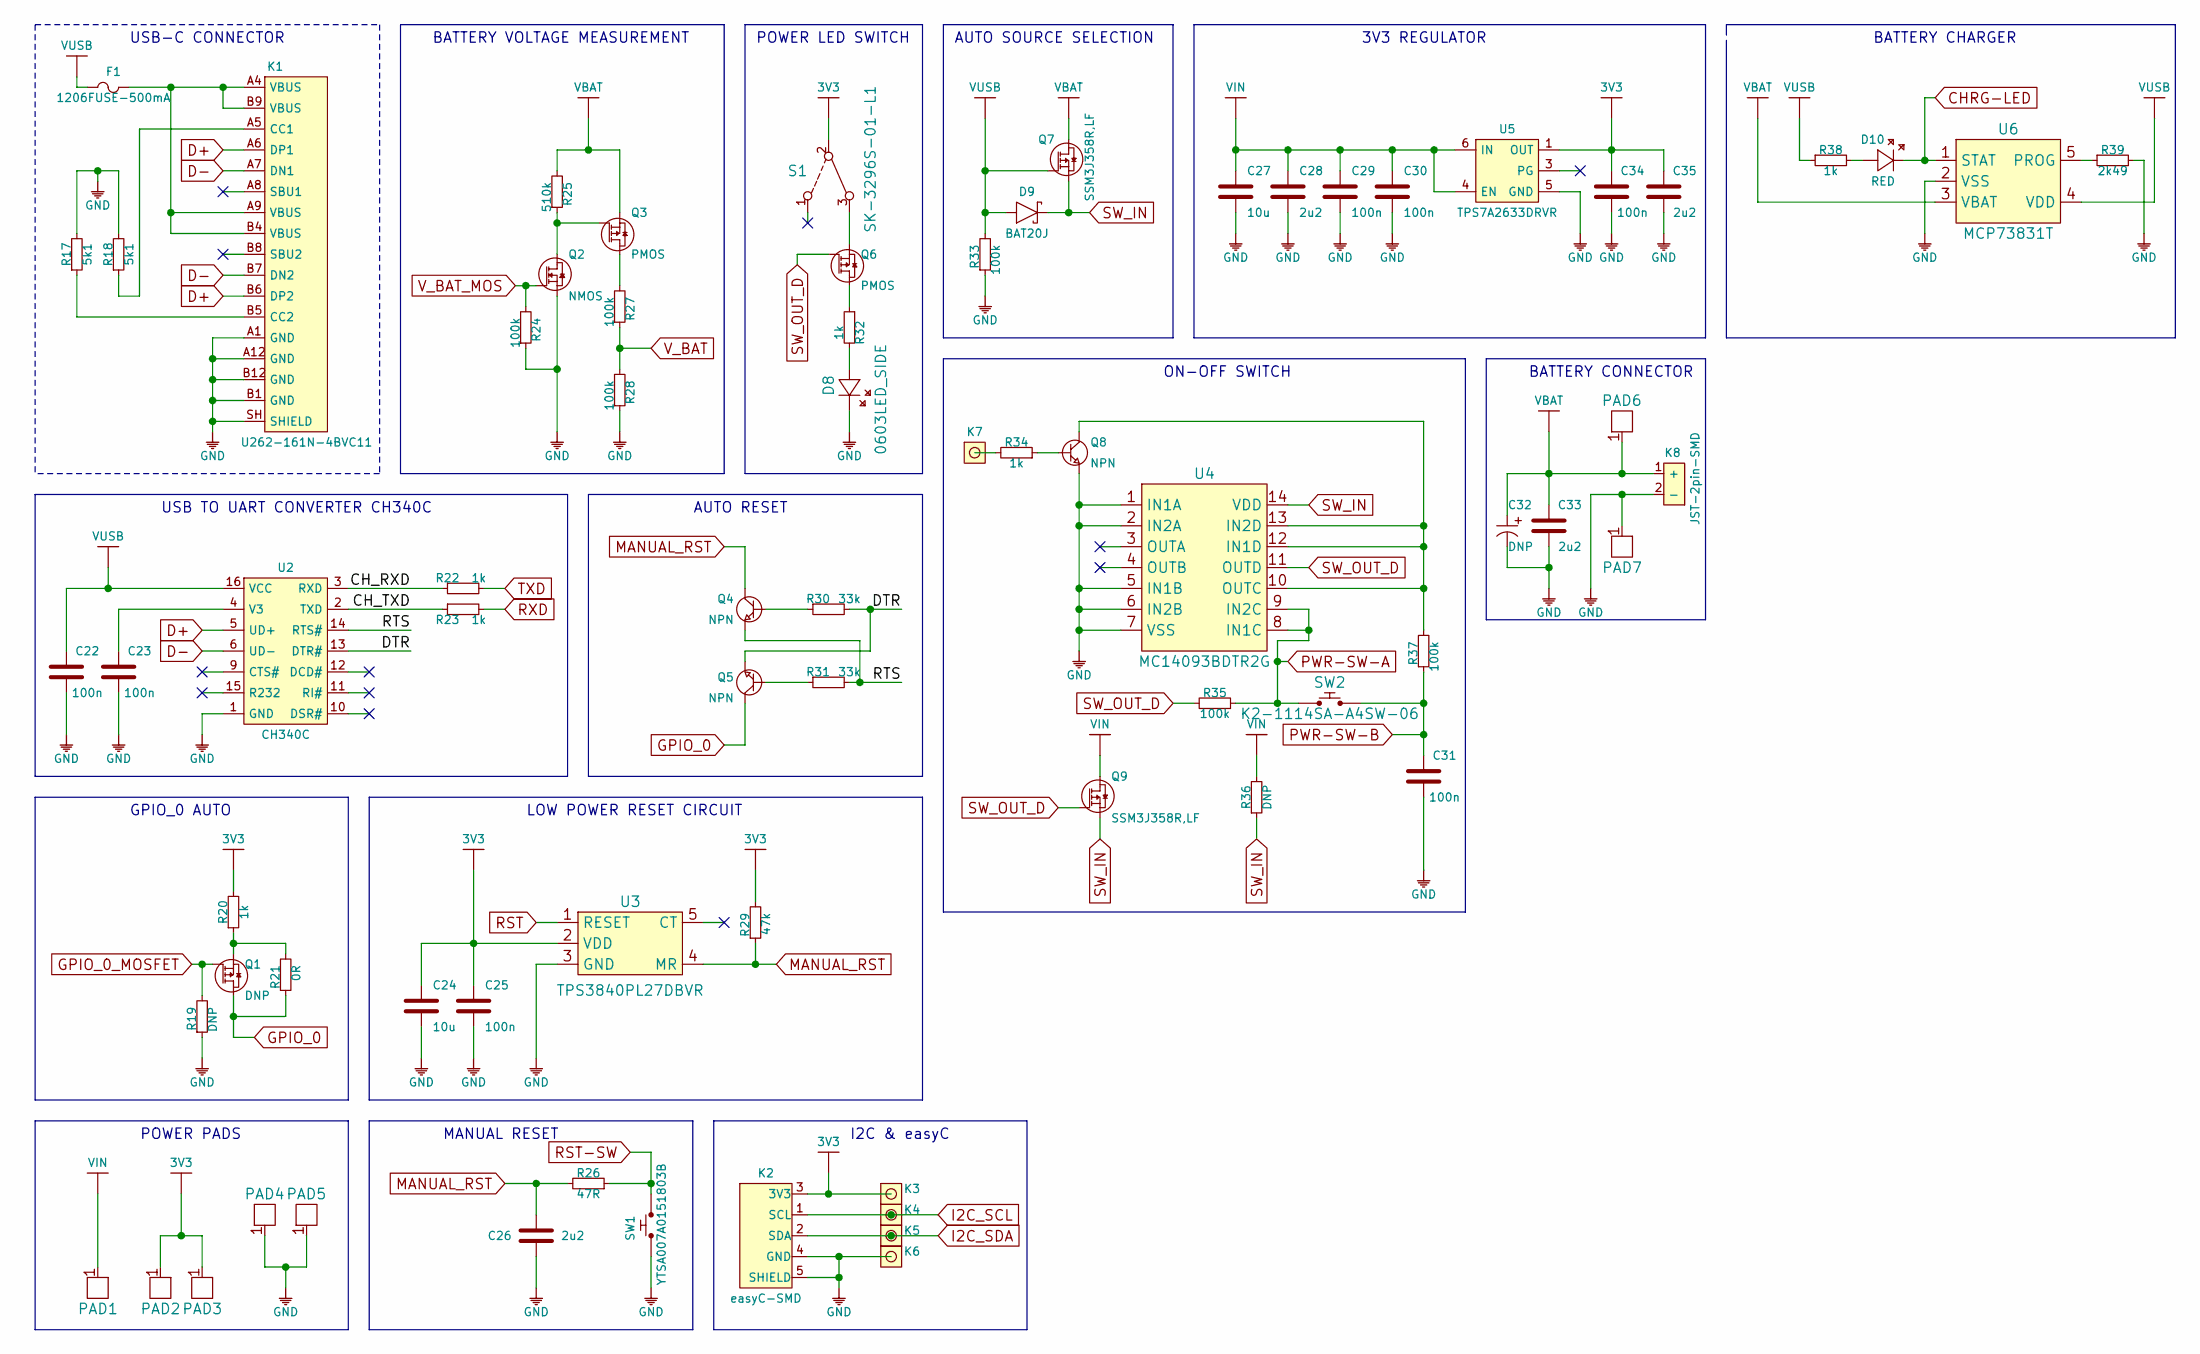
[picture p18: schematic CTRL & COMS.kicad_sch]

Parts:
C22, C23, C25, C29, C30, C31, C34: 100n; 0603C
C24, C27: 10u; 1206C
C26, C28, C33, C35: 2u2; 0603C
C32: DNP; 2917C
D8: 0603LED_SIDE; LTST-S270GKT
D9: BAT20J; SOD-323
D10: RED; 0402LED
F1: 1206FUSE-500mA; 1206FUSE
K1: U262-161N-4BVC11
K2: easyC-SMD; easyC-connector
K3, K4, K5, K6, K7: HEADER_MALE_1X1_Inkplate
K8: JST-2pin-SMD
PAD1, PAD2, PAD3, PAD4, PAD5, PAD6, PAD7: PAD_4x4
Q1: DNP; SOT-23-3
Q2: NMOS; SOT-23-3
Q3, Q6: PMOS; SOT-23-3
Q4, Q5, Q8: NPN; SOT-23-3
Q7, Q9: SSM3J358R,LF; SOT-23-3
R17, R18: 5k1; 0603R
R19, R36: DNP; 0603R
R20, R22, R23, R32, R34, R38: 1k; 0603R
R21: 0R; 0603R
R24, R27, R28, R33, R35, R37: 100k; 0603R
R25: 510k; 0603R
R26: 47R; 0603R
R29: 47k; 0603R
R30, R31: 33k; 0603R
R39: 2k49; 0603R
S1: SK-3296S-01-L1
SW1: YTSA007A0151803B
SW2: K2-1114SA-A4SW-06
U2: CH340C; SOP-16
U3: TPS3840PL27DBVR; SOT-23-5
U4: MC14093BDTR2G; TSSOP-14
U5: TPS7A2633DRVR
U6: MCP73831T; SOT-23-5

Connections:
3V3: C24.2, C25.2, C34.2, C35.2, K2.3 (3V3), K3.1, PAD2.1, PAD3.1, R20.2, R29.2, S1.2, U3.2 (VDD), U5.1 (OUT)
CHRG-LED: D10.2 (K), U6.1 (STAT)
CH_RXD: R22.1, U2.3 (RXD)
CH_TXD: R23.1, U2.2 (TXD)
D+: K1.A6 (DP1), K1.B6 (DP2), U2.5 (UD+)
D-: K1.A7 (DN1), K1.B7 (DN2), U2.6 (UD-)
DTR: Q5.2 (E), R30.2, U2.13 (DTR#)
GND: C22.1, C23.1, C24.1, C25.1, C26.1, C27.1, C28.1, C29.1, C30.1, C31.1, C32.2 (-), C33.1, C34.1, C35.1, D8.2 (K), K1.A1 (GND), K1.A12 (GND), K1.B1 (GND), K1.B12 (GND), K1.SH (SHIELD), K2.4 (GND), K2.5 (SHIELD), K6.1, K8.2 (-), PAD4.1, PAD5.1, PAD7.1, Q2.2 (S), Q8.2 (E), R17.2, R18.2, R19.1, R24.1, R28.1, R33.1, R39.2, SW1.1, U2.1 (GND), U3.3 (GND), U4.1 (IN1A), U4.2 (IN2A), U4.5 (IN1B), U4.6 (IN2B), U4.7 (VSS), U5.5 (GND), U6.2 (VSS)
GPIO_0: Q1.3 (D), Q5.3 (C), R21.1
GPIO_0_MOSFET: Q1.1 (G), R19.2
I2C_SCL: K2.1 (SCL), K4.1
I2C_SDA: K2.2 (SDA), K5.1
MANUAL_RST: C26.2, Q4.3 (C), R26.2, R29.1, U3.4 (MR)
unnamed: C23.2, U2.4 (V3)
unnamed: D8.1 (A), R32.2
unnamed: D10.1 (A), R38.2
unnamed: F1.2, K1.A4 (VBUS), K1.A9 (VBUS), K1.B4 (VBUS), K1.B9 (VBUS)
unnamed: K1.A5 (CC1), R18.1
unnamed: K1.B5 (CC2), R17.1
unnamed: K7.1, R34.2
unnamed: Q1.2 (S), R20.1, R21.2
unnamed: Q2.3 (D), Q3.1 (G), R25.1
unnamed: Q3.3 (D), R27.2
unnamed: Q4.1 (B), R30.1
unnamed: Q5.1 (B), R31.1
unnamed: Q6.2 (S), S1.3
unnamed: Q6.3 (D), R32.1
unnamed: Q8.1 (B), R34.1
unnamed: Q8.3 (C), R37.2, U4.10 (OUTC), U4.12 (IN1D), U4.13 (IN2D)
unnamed: R39.1, U6.5 (PROG)
PWR-SW-A: R35.1, SW2.1, U4.8 (IN1C), U4.9 (IN2C)
PWR-SW-B: C31.2, R37.1, SW2.2
RST: U3.1 (RESET)
RST-SW: R26.1, SW1.2
RTS: Q4.2 (E), R31.2, U2.14 (RTS#)
RXD: R23.2
SW_IN: D9.2 (C), Q7.2 (S), Q9.2 (S), R36.1, U4.14 (VDD)
SW_OUT_D: Q6.1 (G), Q9.1 (G), R35.2, U4.11 (OUTD)
TXD: R22.2
VBAT: C32.1 (+), C33.2, K8.1 (+), PAD6.1, Q3.2 (S), Q7.3 (D), R25.2, U6.3 (VBAT)
VIN: C27.2, C28.2, C29.2, C30.2, PAD1.1, Q9.3 (D), R36.2, U5.4 (EN), U5.6 (IN)
VUSB: C22.2, D9.1 (A), F1.1, Q7.1 (G), R33.2, R38.1, U2.16 (VCC), U6.4 (VDD)
V_BAT: R27.1, R28.2
V_BAT_MOS: Q2.1 (G), R24.2

Notes on the sheet:
USB TO UART CONVERTER CH340C
AUTO SOURCE SELECTION
AUTO RESET
I2C & easyC
ON-OFF SWITCH
POWER LED SWITCH
GPIO_0 AUTO
BATTERY VOLTAGE MEASUREMENT
3V3 REGULATOR
USB-C CONNECTOR
POWER PADS
MANUAL RESET
LOW POWER RESET CIRCUIT
BATTERY CONNECTOR
BATTERY CHARGER
