SolderedElectronics/Soldered-Inkplate-6-FLICK-hardware-design/CAD/V1.2.0/E-paper.kicad_sch

## KiCad design CAD/V1.2.0/E-paper.kicad_sch (2024-10-20)

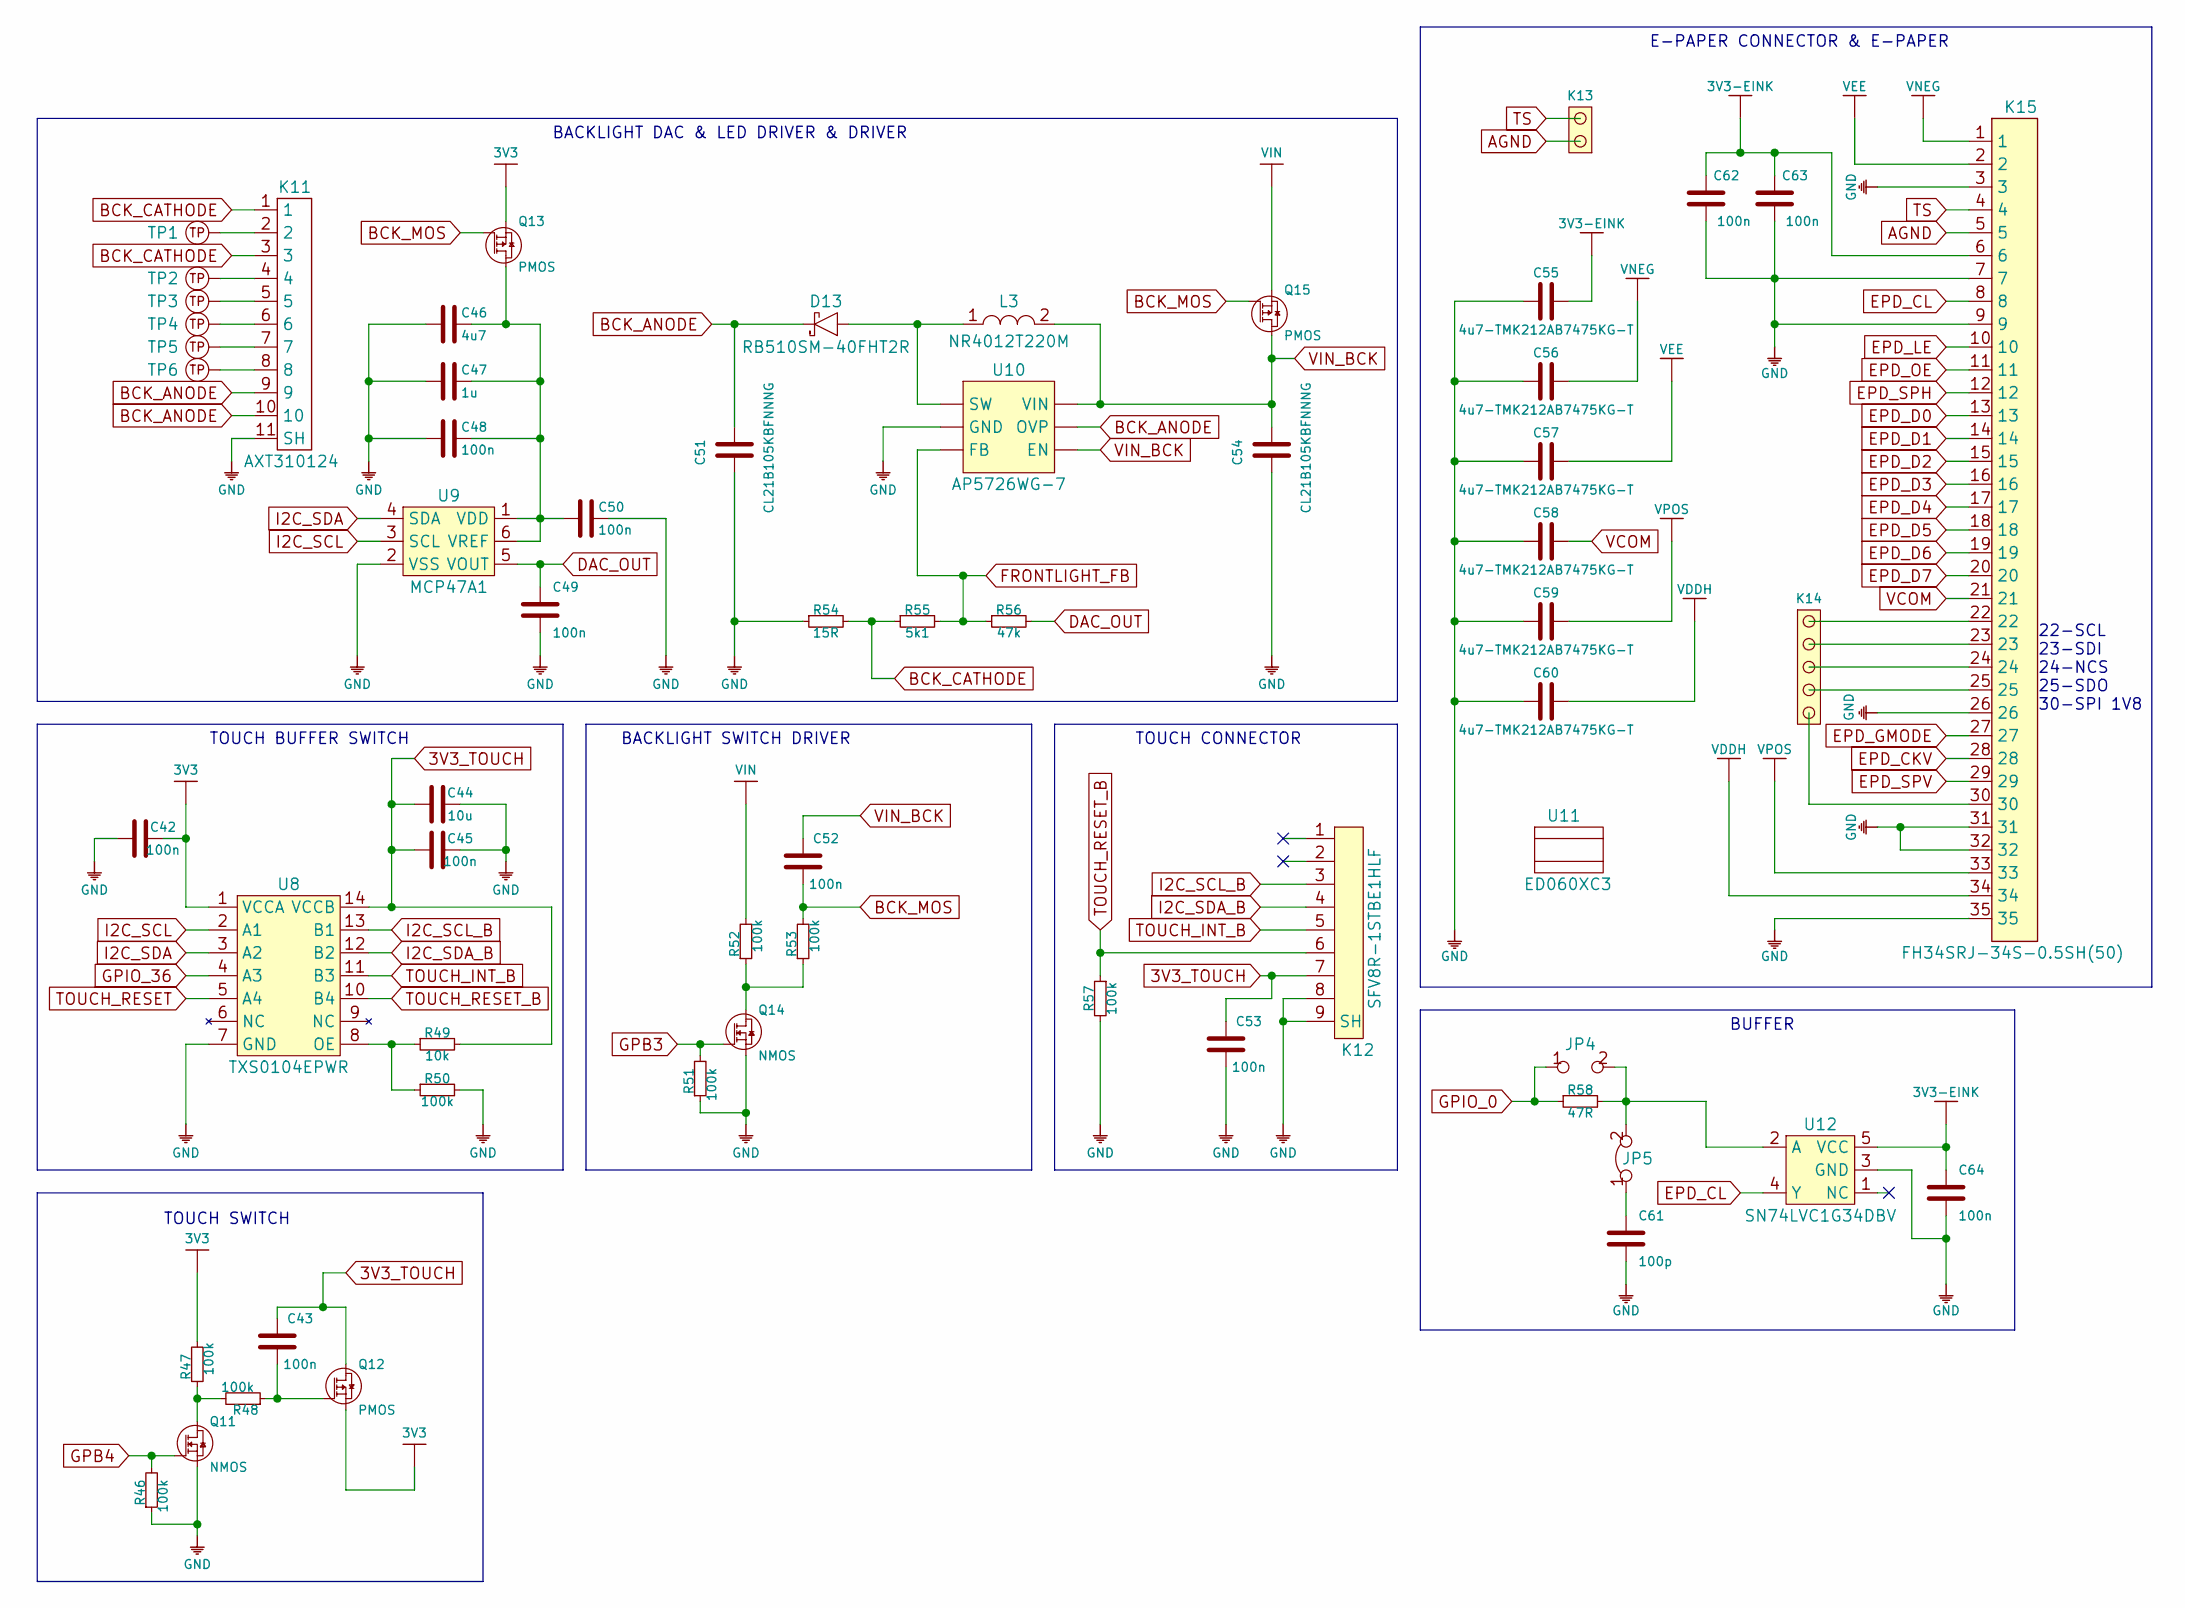
[picture p19: schematic E-paper.kicad_sch]

Parts:
C42, C43, C45, C48, C49, C50, C52, C53, C62, C63, C64: 100n; 0603C
C44: 10u; 1206C
C46: 4u7; 0603C
C47: 1u; 0603C
C51, C54: CL21B105KBFNNNG; 0805C
C55, C56, C57, C58, C59, C60: 4u7-TMK212AB7475KG-T; 0805C
C61: 100p; 0603C
D13: RB510SM-40FHT2R; SOD-523
JP4: SMD_JUMPER
JP5: SMD-JUMPER-CONNECTED_TRACE_SOLDERMASK
K11: AXT310124
K12: SFV8R-1STBE1HLF
K13: HEADER_MALE_2X1
K14: HEADER_MALE_5X1
K15: FH34SRJ-34S-0.5SH(50)
L3: NR4012T220M; NR4012
Q11, Q14: NMOS; SOT-23-3
Q12, Q13, Q15: PMOS; SOT-23-3
R46, R47, R48, R50, R51, R52, R53, R57: 100k; 0603R
R49: 10k; 0603R
R54: 15R; 0603R
R55: 5k1; 0603R
R56: 47k; 0603R
R58: 47R; 0603R
TP1, TP2, TP3, TP4, TP5, TP6: Test_Point_SMD_0.8mm
U8: TXS0104EPWR
U9: MCP47A1; MCP47A1-SOT23-6
U10: AP5726WG-7; SOT26
U11: ED060XC3
U12: SN74LVC1G34DBV

Connections:
3V3: C42.2, Q12.2 (S), Q13.2 (S), R47.2, U8.1 (VCCA)
3V3-EINK: C55.2, C62.1, C63.1, C64.2, K15.6, U12.5 (VCC)
3V3_TOUCH: C43.2, C44.1, C45.1, C53.2, K12.7, Q12.3 (D), R49.2, U8.14 (VCCB)
AGND: K13.1, K15.5
BCK_ANODE: C51.2, D13.2 (K), K11.9, K11.10, U10.5 (OVP)
BCK_CATHODE: K11.1, K11.3, R54.2, R55.1
BCK_MOS: C52.1, Q13.1 (G), Q15.1 (G), R53.2
DAC_OUT: C49.2, R56.2, U9.5 (VOUT)
EPD_CKV: K15.28
EPD_CL: K15.8, U12.4 (Y)
EPD_D0: K15.13
EPD_D1: K15.14
EPD_D2: K15.15
EPD_D3: K15.16
EPD_D4: K15.17
EPD_D5: K15.18
EPD_D6: K15.19
EPD_D7: K15.20
EPD_GMODE: K15.27
EPD_LE: K15.10
EPD_OE: K15.11
EPD_SPH: K15.12
EPD_SPV: K15.29
FRONTLIGHT_FB: R55.2, R56.1, U10.3 (FB)
GND: C42.1, C44.2, C45.2, C46.2, C47.2, C48.2, C49.1, C50.1, C51.1, C53.1, C54.1, C55.1, C56.1, C57.1, C58.1, C59.1, C60.1, C61.1, C62.2, C63.2, C64.1, K11.11 (SH), K12.8, K12.9 (SH), K15.3, K15.7, K15.9, K15.26, K15.31, K15.32, K15.35, Q11.2 (S), Q14.2 (S), R46.1, R50.2, R51.1, R54.1, R57.2, U8.7 (GND), U9.2 (VSS), U10.2 (GND), U12.3 (GND)
GPB3: Q14.1 (G), R51.2
GPB4: Q11.1 (G), R46.2
GPIO_0: JP4.1, R58.1
GPIO_36: U8.4 (A3)
I2C_SCL: U8.2 (A1), U9.3 (SCL)
I2C_SCL_B: K12.3, U8.13 (B1)
I2C_SDA: U8.3 (A2), U9.4 (SDA)
I2C_SDA_B: K12.4, U8.12 (B2)
unnamed: C43.1, Q12.1 (G), R48.1
unnamed: C46.1, C47.1, C48.1, C50.2, Q13.3 (D), U9.1 (VDD), U9.6 (VREF)
unnamed: C61.2, JP5.1
unnamed: D13.1 (A), L3.1, U10.1 (SW)
unnamed: JP4.2, JP5.2, R58.2, U12.2 (A)
unnamed: K11.2, TP1.TP
unnamed: K11.4, TP2.TP
unnamed: K11.5, TP3.TP
unnamed: K11.6, TP4.TP
unnamed: K11.7, TP5.TP
unnamed: K11.8, TP6.TP
unnamed: K14.1, K15.30
unnamed: K14.2, K15.25
unnamed: K14.3, K15.24
unnamed: K14.4, K15.23
unnamed: K14.5, K15.22
unnamed: Q11.3 (D), R47.1, R48.2
unnamed: Q14.3 (D), R52.1, R53.1
unnamed: R49.1, R50.1, U8.8 (OE)
TOUCH_INT_B: K12.5, U8.11 (B3)
TOUCH_RESET: U8.5 (A4)
TOUCH_RESET_B: K12.6, R57.1, U8.10 (B4)
TS: K13.2, K15.4
VCOM: C58.2, K15.21
VDDH: C60.2, K15.34
VEE: C57.2, K15.2
VIN: Q15.2 (S), R52.2
VIN_BCK: C52.2, C54.2, L3.2, Q15.3 (D), U10.4 (EN), U10.6 (VIN)
VNEG: C56.2, K15.1
VPOS: C59.2, K15.33

Notes on the sheet:
BACKLIGHT DAC & LED DRIVER & DRIVER
TOUCH CONNECTOR
TOUCH BUFFER SWITCH
BACKLIGHT SWITCH DRIVER
E-PAPER CONNECTOR & E-PAPER
BUFFER
TOUCH SWITCH
22-SCL 23-SDI 24-NCS 25-SDO 30-SPI 1V8
