SolderedElectronics/Soldered-Inkplate-6-FLICK-hardware-design/CAD/V1.2.0/MCU & GPIO Expanders.kicad_sch

## KiCad design CAD/V1.2.0/MCU & GPIO Expanders.kicad_sch (2024-10-20)

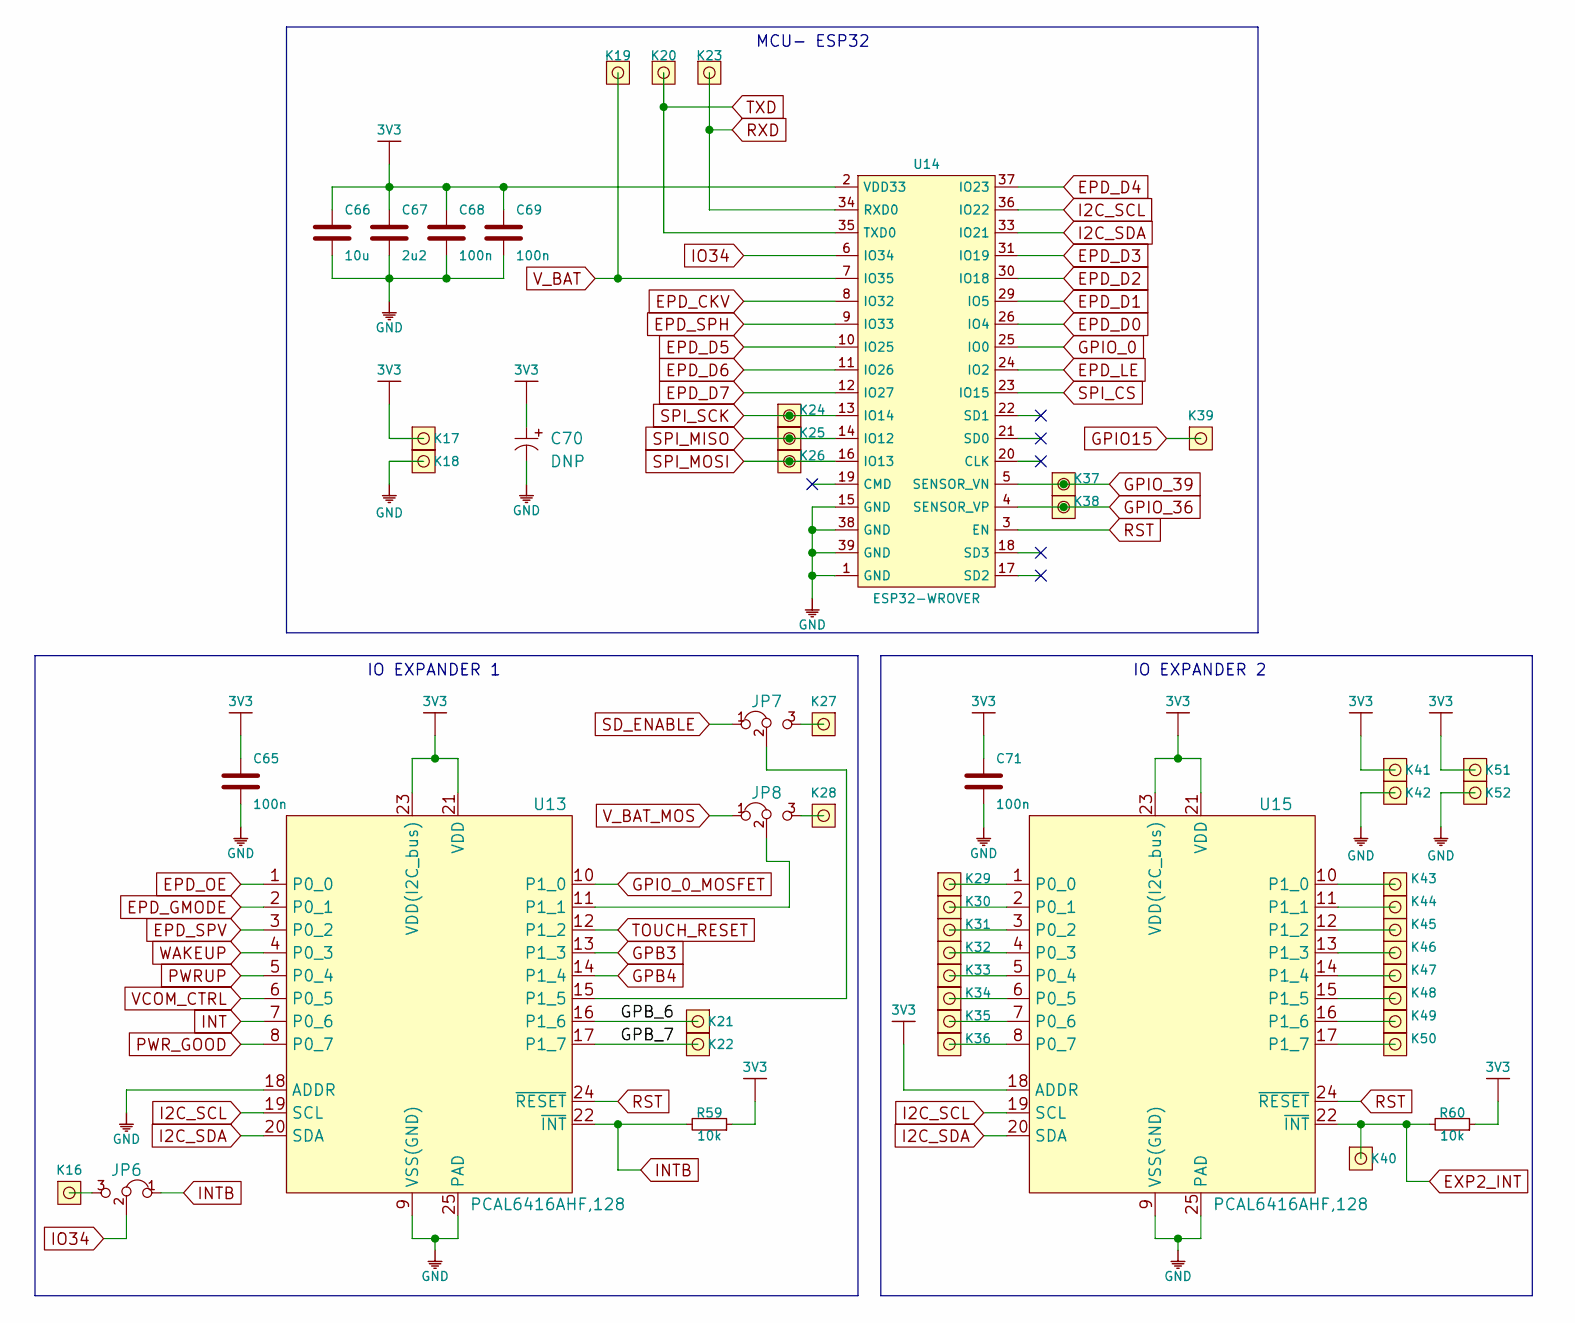
[picture p20: schematic MCU & GPIO Expanders.kicad_sch]

Parts:
C65, C68, C69, C71: 100n; 0603C
C66: 10u; 1206C
C67: 2u2; 0603C
C70: DNP; 2917C
JP6, JP7, JP8: SMD_JUMPER_3_PAD_CONNECTED_LEFT_TRACE
K16, K17, K18, K19, K20, K21, K22, K23, K24, K25, K26, K27, K28, K29, K30, K31, K32, K33, K34, K35, K36, K37, K38, K39, K40, K41, K42, K43, K44, K45, K46, K47, K48, K49, K50, K51, K52: HEADER_MALE_1X1_Inkplate
R59, R60: 10k; 0603R
U13, U15: PCAL6416AHF,128
U14: ESP32-WROVER

Connections:
3V3: C65.2, C66.2, C67.2, C68.2, C69.2, C70.1 (+), C71.2, K17.1, K41.1, K51.1, R59.1, R60.1, U13.21 (VDD), U13.23 (VDD(I2C_bus)), U14.2 (VDD33), U15.18 (ADDR), U15.21 (VDD), U15.23 (VDD(I2C_bus))
EPD_CKV: U14.8 (IO32)
EPD_D0: U14.26 (IO4)
EPD_D1: U14.29 (IO5)
EPD_D2: U14.30 (IO18)
EPD_D3: U14.31 (IO19)
EPD_D4: U14.37 (IO23)
EPD_D5: U14.10 (IO25)
EPD_D6: U14.11 (IO26)
EPD_D7: U14.12 (IO27)
EPD_GMODE: U13.2 (P0_1)
EPD_LE: U14.24 (IO2)
EPD_OE: U13.1 (P0_0)
EPD_SPH: U14.9 (IO33)
EPD_SPV: U13.3 (P0_2)
EXP2_INT: K40.1, R60.2, U15.22 (~INT)
GND: C65.1, C66.1, C67.1, C68.1, C69.1, C70.2 (-), C71.1, K18.1, K42.1, K52.1, U13.9 (VSS(GND)), U13.18 (ADDR), U13.25 (PAD), U14.1 (GND), U14.15 (GND), U14.38 (GND), U14.39 (GND), U15.9 (VSS(GND)), U15.25 (PAD)
GPB3: U13.13 (P1_3)
GPB4: U13.14 (P1_4)
GPB_6: K21.1, U13.16 (P1_6)
GPB_7: K22.1, U13.17 (P1_7)
GPIO15: K39.1
GPIO_0: U14.25 (IO0)
GPIO_0_MOSFET: U13.10 (P1_0)
GPIO_36: K38.1, U14.4 (SENSOR_VP)
GPIO_39: K37.1, U14.5 (SENSOR_VN)
I2C_SCL: U13.19 (SCL), U14.36 (IO22), U15.19 (SCL)
I2C_SDA: U13.20 (SDA), U14.33 (IO21), U15.20 (SDA)
INT: U13.7 (P0_6)
INTB: JP6.1, R59.2, U13.22 (~INT)
IO34: JP6.2, U14.6 (IO34)
unnamed: JP6.3, K16.1
unnamed: JP7.2, U13.15 (P1_5)
unnamed: JP7.3, K27.1
unnamed: JP8.2, U13.11 (P1_1)
unnamed: JP8.3, K28.1
unnamed: K29.1, U15.1 (P0_0)
unnamed: K30.1, U15.2 (P0_1)
unnamed: K31.1, U15.3 (P0_2)
unnamed: K32.1, U15.4 (P0_3)
unnamed: K33.1, U15.5 (P0_4)
unnamed: K34.1, U15.6 (P0_5)
unnamed: K35.1, U15.7 (P0_6)
unnamed: K36.1, U15.8 (P0_7)
unnamed: K43.1, U15.10 (P1_0)
unnamed: K44.1, U15.11 (P1_1)
unnamed: K45.1, U15.12 (P1_2)
unnamed: K46.1, U15.13 (P1_3)
unnamed: K47.1, U15.14 (P1_4)
unnamed: K48.1, U15.15 (P1_5)
unnamed: K49.1, U15.16 (P1_6)
unnamed: K50.1, U15.17 (P1_7)
PWRUP: U13.5 (P0_4)
PWR_GOOD: U13.8 (P0_7)
RST: U13.24 (~RESET), U14.3 (EN), U15.24 (~RESET)
RXD: K23.1, U14.34 (RXD0)
SD_ENABLE: JP7.1
SPI_CS: U14.23 (IO15)
SPI_MISO: K25.1, U14.14 (IO12)
SPI_MOSI: K26.1, U14.16 (IO13)
SPI_SCK: K24.1, U14.13 (IO14)
TOUCH_RESET: U13.12 (P1_2)
TXD: K20.1, U14.35 (TXD0)
VCOM_CTRL: U13.6 (P0_5)
V_BAT: K19.1, U14.7 (IO35)
V_BAT_MOS: JP8.1
WAKEUP: U13.4 (P0_3)

Notes on the sheet:
MCU- ESP32
IO EXPANDER 2
IO EXPANDER 1
