SolderedElectronics/Soldered-Inkplate-6-FLICK-hardware-design/CAD/V1.2.0/SD_RTC_GPIO.kicad_sch

## KiCad design CAD/V1.2.0/SD_RTC_GPIO.kicad_sch (2024-10-20)

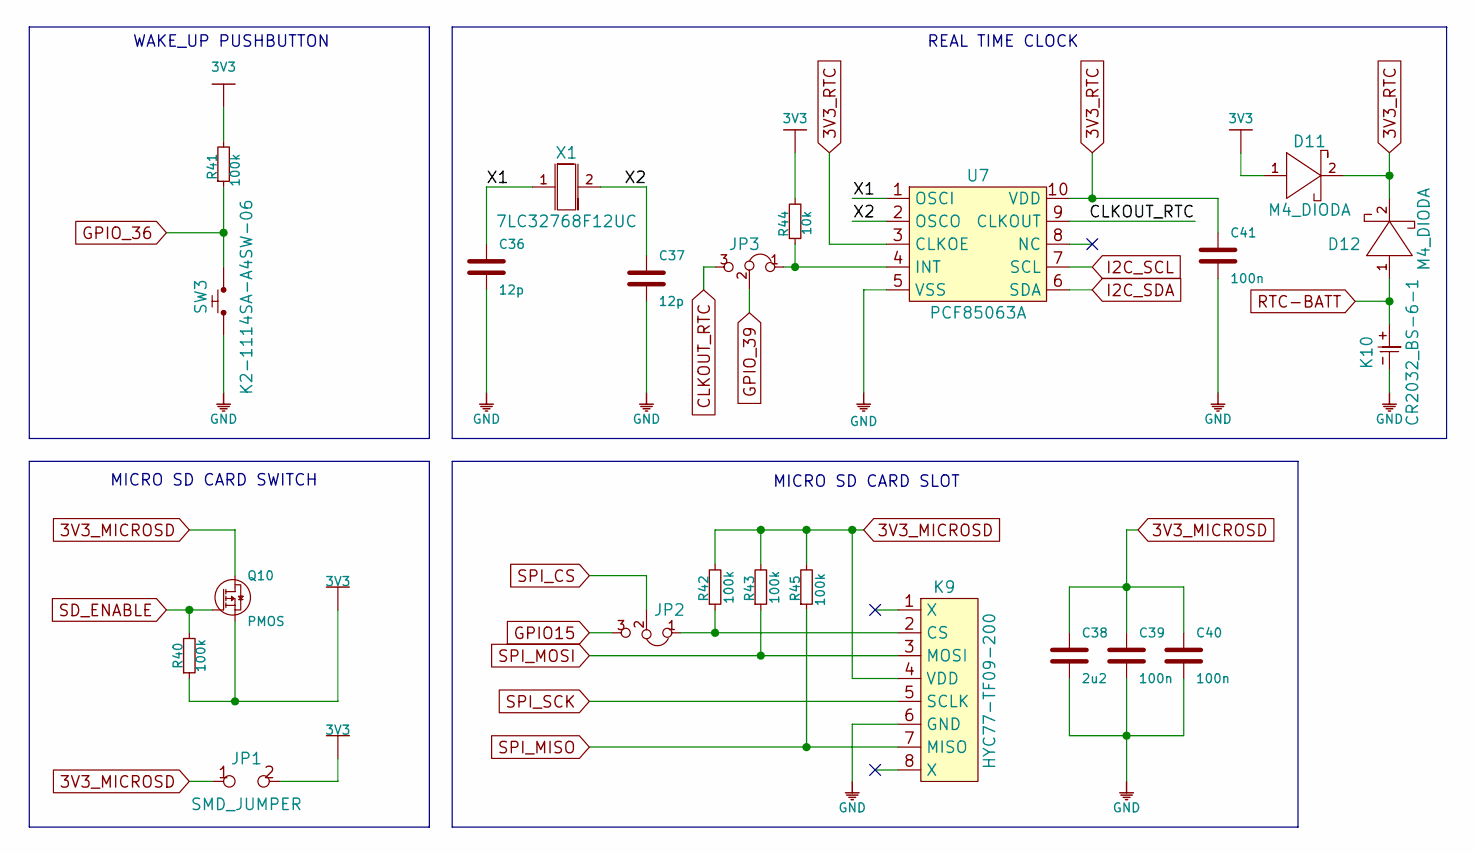
[picture p22: schematic SD_RTC_GPIO.kicad_sch]

Parts:
C36, C37: 12p; 0603C
C38: 2u2; 0603C
C39, C40, C41: 100n; 0603C
D11, D12: M4_DIODA
JP1: SMD_JUMPER
JP2, JP3: SMD_JUMPER_3_PAD_CONNECTED_LEFT_TRACE
K9: HYC77-TF09-200
K10: CR2032_BS-6-1; CR2032-BS-6-1
Q10: PMOS; SOT-23-3
R40, R41, R42, R43, R45: 100k; 0603R
R44: 10k; 0603R
SW3: K2-1114SA-A4SW-06
U7: PCF85063A
X1: 7LC32768F12UC; ABS07AIG-32.768KHZ-7-D-T

Connections:
3V3: D11.1 (A), JP1.2, Q10.2 (S), R40.1, R41.2, R44.2
3V3_MICROSD: C38.2, C39.2, C40.2, JP1.1, K9.4 (VDD), Q10.3 (D), R42.2, R43.2, R45.2
3V3_RTC: C41.2, D11.2 (K), D12.2 (K), U7.3 (CLKOE), U7.10 (VDD)
CLKOUT_RTC: JP3.3, U7.9 (CLKOUT)
GND: C36.1, C37.1, C38.1, C39.1, C40.1, C41.1, K9.6 (GND), K10.-, SW3.1, U7.5 (VSS)
GPIO15: JP2.3
GPIO_36: R41.1, SW3.2
GPIO_39: JP3.2
I2C_SCL: U7.7 (SCL)
I2C_SDA: U7.6 (SDA)
unnamed: JP2.1, K9.2 (CS), R42.1
unnamed: JP3.1, R44.1, U7.4 (INT)
RTC-BATT: D12.1 (A), K10.+
SD_ENABLE: Q10.1 (G), R40.2
SPI_CS: JP2.2
SPI_MISO: K9.7 (MISO), R45.1
SPI_MOSI: K9.3 (MOSI), R43.1
SPI_SCK: K9.5 (SCLK)
X1: C36.2, U7.1 (OSCI), X1.1
X2: C37.2, U7.2 (OSCO), X1.2

Notes on the sheet:
REAL TIME CLOCK
WAKE_UP PUSHBUTTON
MICRO SD CARD SWITCH
MICRO SD CARD SLOT
