SolderedElectronics/Soldered-Inkplate-6-FLICK-hardware-design/CAD/V1.2.0/TestPoints.kicad_sch

## KiCad design CAD/V1.2.0/TestPoints.kicad_sch (2024-10-20)

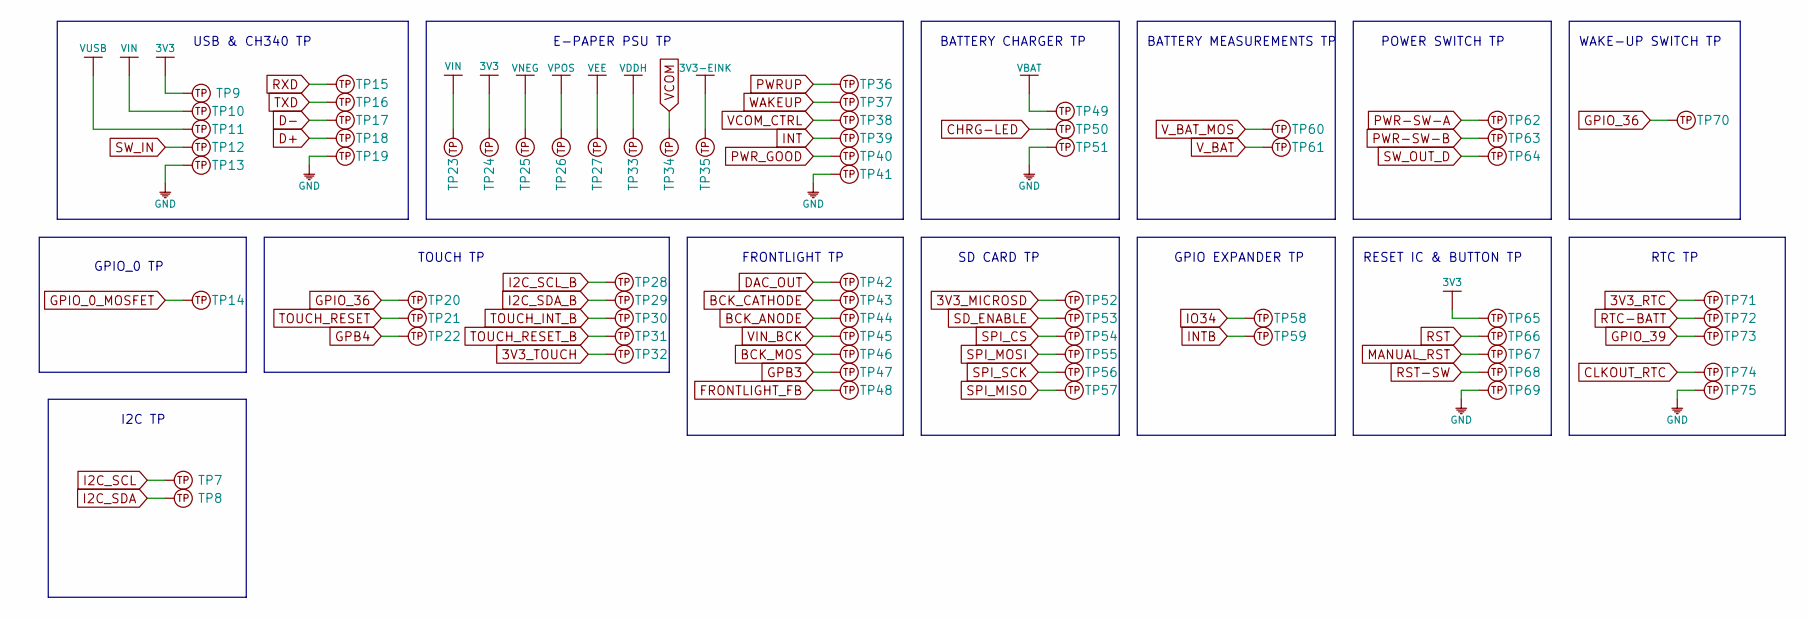
[picture p23: schematic TestPoints.kicad_sch]

Parts:
TP7, TP8, TP9, TP10, TP11, TP12, TP13, TP14, TP15, TP16, TP17, TP18, TP19, TP20, TP21, TP22, TP23, TP24, TP25, TP26, TP27, TP28, TP29, TP30, TP31, TP32, TP33, TP34, TP35, TP36, TP37, TP38, TP39, TP40, TP41, TP42, TP43, TP44, TP45, TP46, TP47, TP48, TP49, TP50, TP51, TP52, TP53, TP54, TP55, TP56, TP57, TP58, TP59, TP60, TP61, TP62, TP63, TP64, TP65, TP66, TP67, TP68, TP69, TP70, TP71, TP72, TP73, TP74, TP75: Test_Point_SMD_0.8mm

Connections:
3V3: TP9.TP, TP24.TP, TP65.TP
3V3-EINK: TP35.TP
3V3_MICROSD: TP52.TP
3V3_RTC: TP71.TP
3V3_TOUCH: TP32.TP
BCK_ANODE: TP44.TP
BCK_CATHODE: TP43.TP
BCK_MOS: TP46.TP
CHRG-LED: TP50.TP
CLKOUT_RTC: TP74.TP
D+: TP18.TP
D-: TP17.TP
DAC_OUT: TP42.TP
FRONTLIGHT_FB: TP48.TP
GND: TP13.TP, TP19.TP, TP41.TP, TP51.TP, TP69.TP, TP75.TP
GPB3: TP47.TP
GPB4: TP22.TP
GPIO_0_MOSFET: TP14.TP
GPIO_36: TP20.TP, TP70.TP
GPIO_39: TP73.TP
I2C_SCL: TP7.TP
I2C_SCL_B: TP28.TP
I2C_SDA: TP8.TP
I2C_SDA_B: TP29.TP
INT: TP39.TP
INTB: TP59.TP
IO34: TP58.TP
MANUAL_RST: TP67.TP
PWR-SW-A: TP62.TP
PWR-SW-B: TP63.TP
PWRUP: TP36.TP
PWR_GOOD: TP40.TP
RST: TP66.TP
RST-SW: TP68.TP
RTC-BATT: TP72.TP
RXD: TP15.TP
SD_ENABLE: TP53.TP
SPI_CS: TP54.TP
SPI_MISO: TP57.TP
SPI_MOSI: TP55.TP
SPI_SCK: TP56.TP
SW_IN: TP12.TP
SW_OUT_D: TP64.TP
TOUCH_INT_B: TP30.TP
TOUCH_RESET: TP21.TP
TOUCH_RESET_B: TP31.TP
TXD: TP16.TP
VBAT: TP49.TP
VCOM: TP34.TP
VCOM_CTRL: TP38.TP
VDDH: TP33.TP
VEE: TP27.TP
VIN: TP10.TP, TP23.TP
VIN_BCK: TP45.TP
VNEG: TP25.TP
VPOS: TP26.TP
VUSB: TP11.TP
V_BAT: TP61.TP
V_BAT_MOS: TP60.TP
WAKEUP: TP37.TP

Notes on the sheet:
GPIO EXPANDER TP
FRONTLIGHT TP
BATTERY MEASUREMENTS TP
POWER SWITCH TP
RESET IC & BUTTON TP
BATTERY CHARGER TP
GPIO_0 TP
SD CARD TP
I2C TP
USB & CH340 TP
WAKE-UP SWITCH TP
RTC TP
E-PAPER PSU TP
TOUCH TP
